corlov/river-gauge/doc/schemas/pinout/pro-micro-pinout.jpg

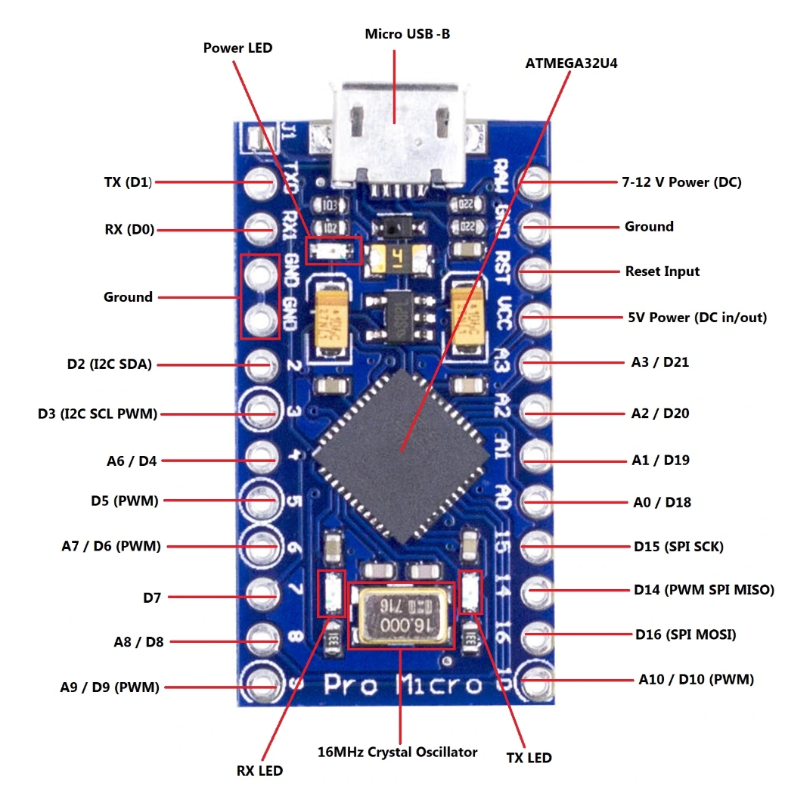
doc/schemas/pinout/pro-micro-pinout.jpg
