corlov/river-gauge/doc/schemas/pinout/sim800L.jpg

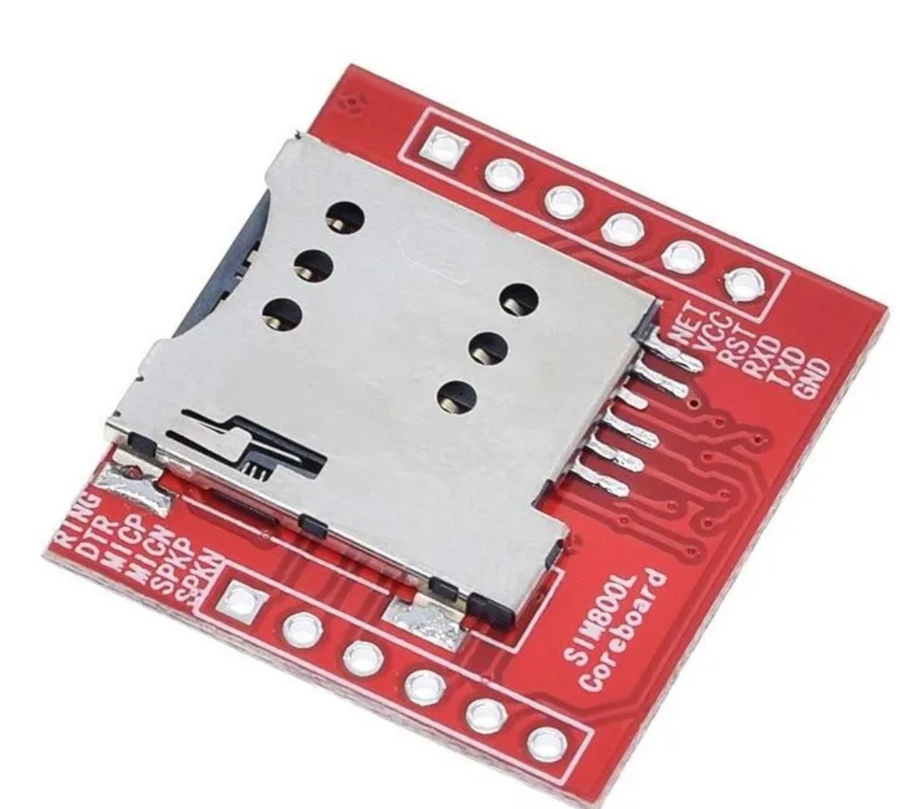
doc/schemas/pinout/sim800L.jpg
