corlov/river-gauge/code/firmware/prod/full_device_esp32_v.08.02.2026/README.md

1) отправлять старые данные
2) резервный сервевер при отправке по MQTT
3) подумать о добавлении признака - это полные данные или только с некоторых сеносров
4) коды ошибок вынести в отдельный модуль как и функцию работы с ними
5) проанализировать какие есть неиспользуемые функции, какие то функци перенести в другие модули

// --- Карта пинов для платы ESP32-S3 ---

// --- Аналоговые пины (ADC1) ---
// A0 = GPIO 1
// A1 = GPIO 2
// A2 = GPIO 3
// A3 = GPIO 4
// A4 = GPIO 5

// --- Встроенные устройства ---
// LED_BUILTIN = 97
//  (Это 'виртуальный' пин для RGB светодиода)

// --- Аппаратный I2C (Wire) ---
// SDA = GPIO 8
// SCL = GPIO 9

// --- Аппаратный SPI ---
// MOSI = GPIO 11
// MISO = GPIO 13
// SCK = GPIO 12
// SS (CS) = GPIO 10

// --- Аппаратный Serial (UART0) ---
// TX = GPIO 43
// RX = GPIO 44
// =============================================================================
