corlov/river-gauge/doc/schemas/pinout/2n2222.jpg

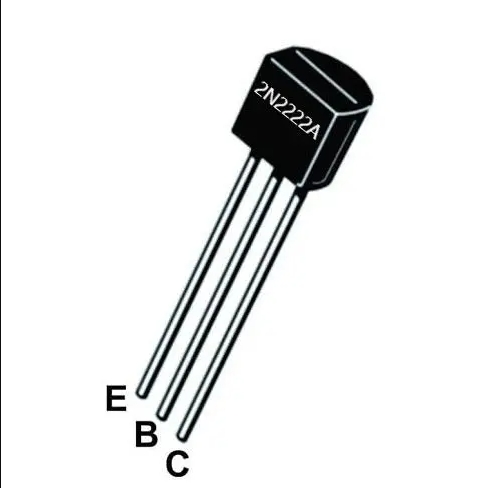
doc/schemas/pinout/2n2222.jpg
