corlov/river-gauge/doc/schemas/pinout/75xx.jpeg

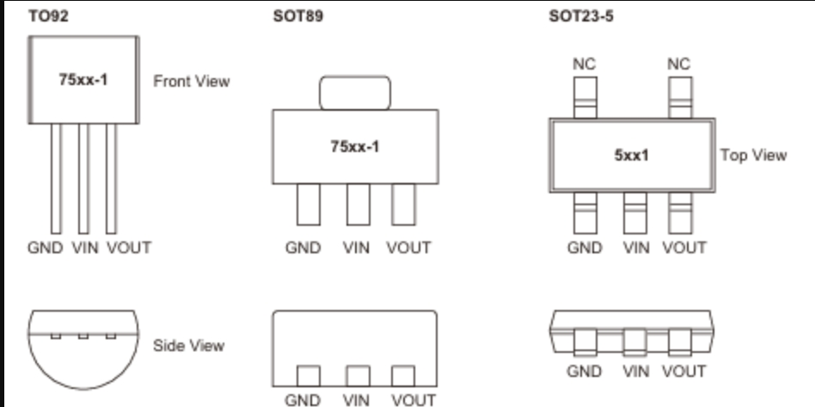
doc/schemas/pinout/75xx.jpeg
