corlov/river-gauge/doc/schemas/pinout/7333A.jpeg

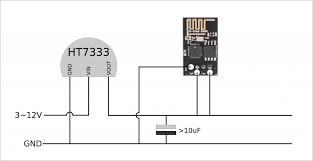
doc/schemas/pinout/7333A.jpeg
