corlov/river-gauge/doc/schemas/pinout/монтаж датчика уровня жидкости.jpg

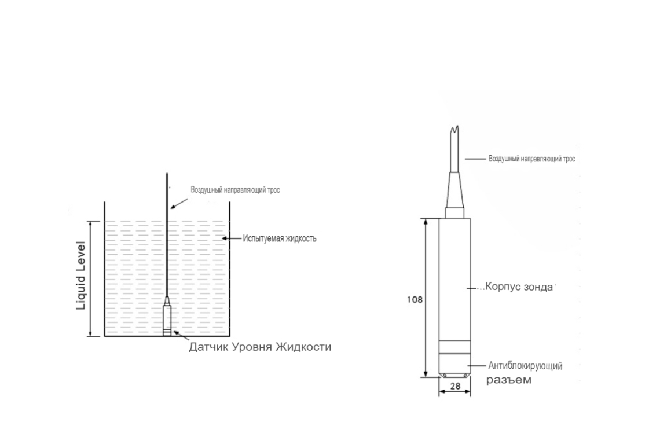
doc/schemas/pinout/монтаж датчика уровня жидкости.jpg
