corlov/river-gauge/doc/schemas/блочная схема/схема.drawio.png

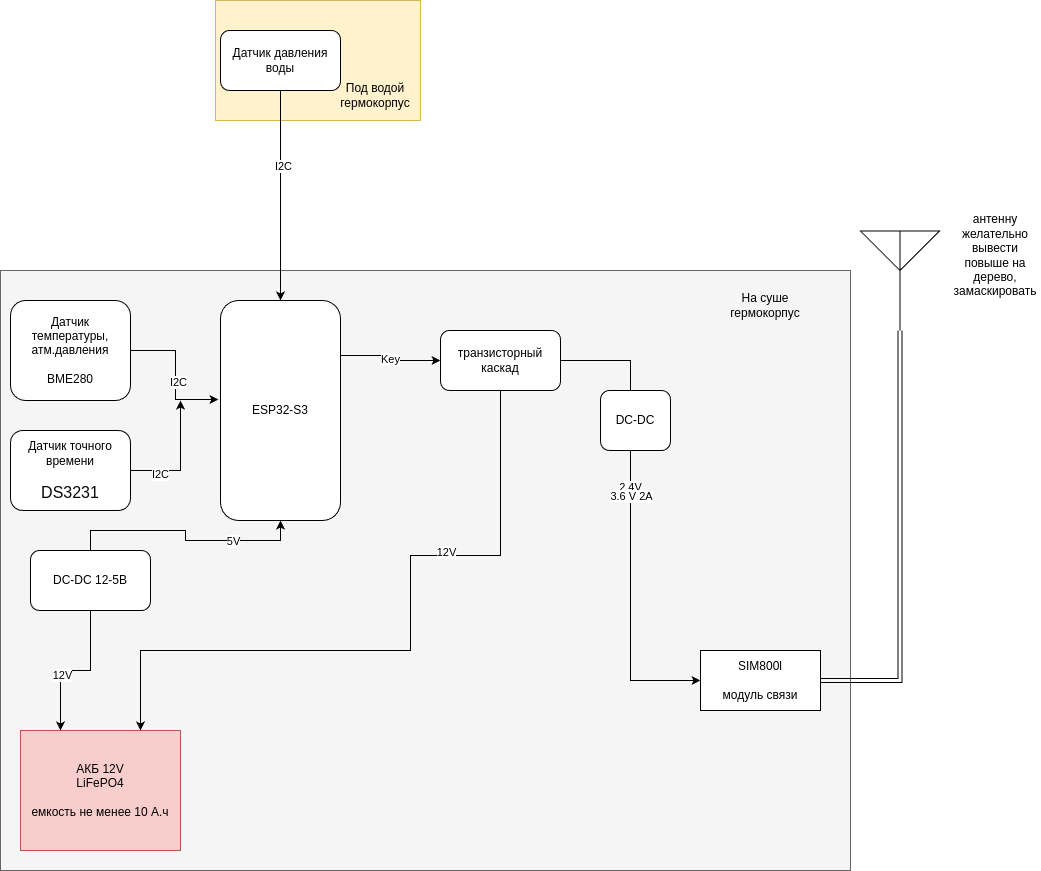
doc/schemas/блочная схема/схема.drawio.png
