corlov/river-gauge/doc/schemas/Общая схема.drawio.png

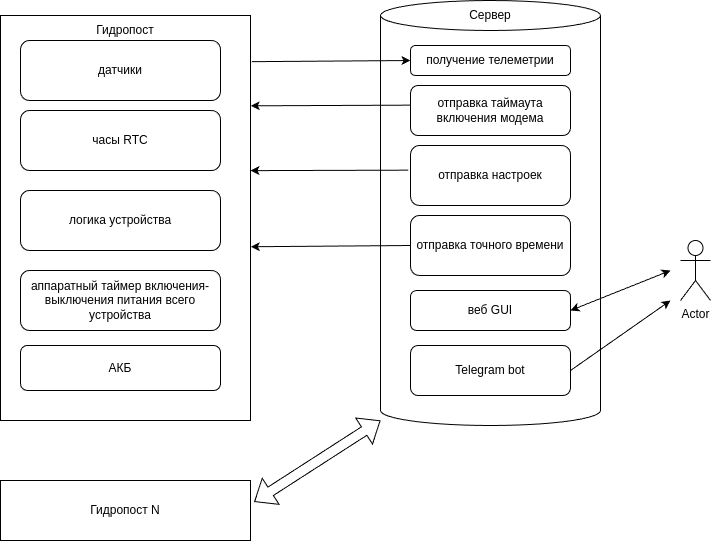
doc/schemas/Общая схема.drawio.png
