corlov/river-gauge/doc/Этапы сборки схемы.jpg

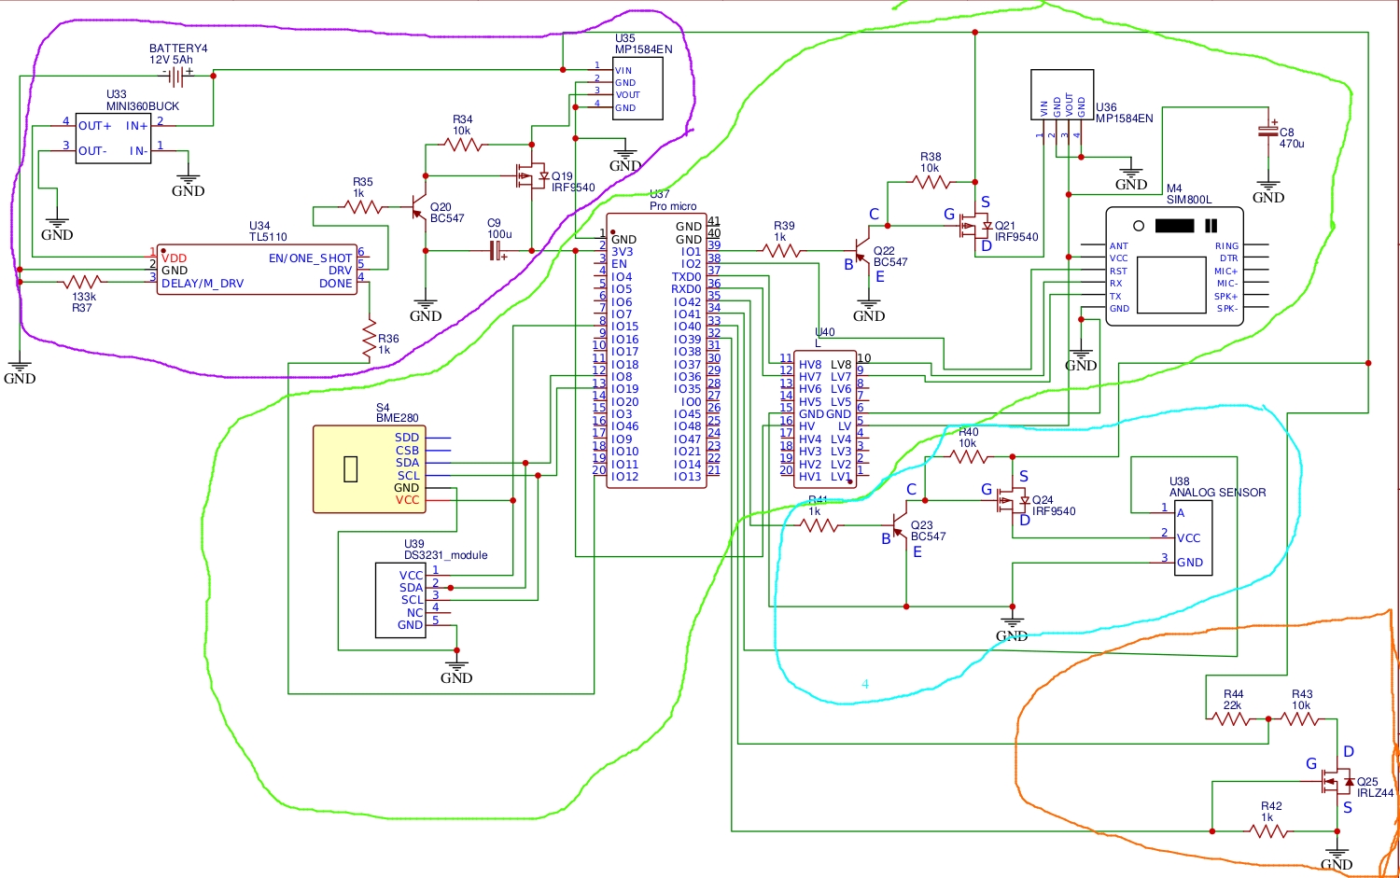
doc/Этапы сборки схемы.jpg
