corlov/river-gauge/pcb_photo_evolution/oct2025/photo_2026-02-10_19-11-00.jpg

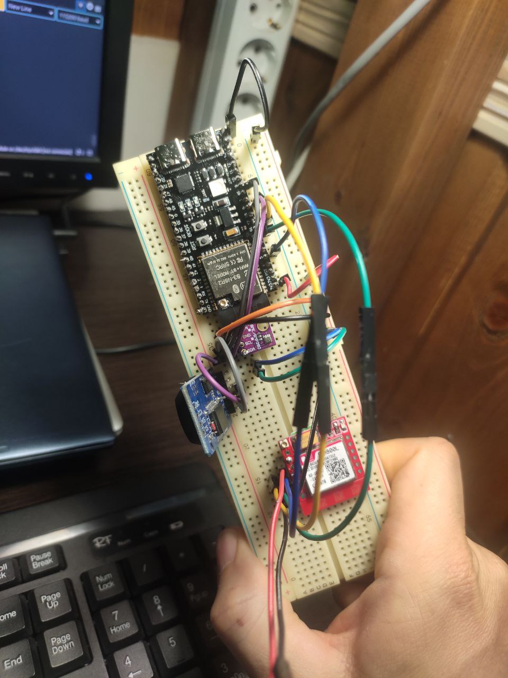
pcb_photo_evolution/oct2025/photo_2026-02-10_19-11-00.jpg
