corlov/river-gauge/pcb_photo_evolution/oct2025/rx-tx.jpg

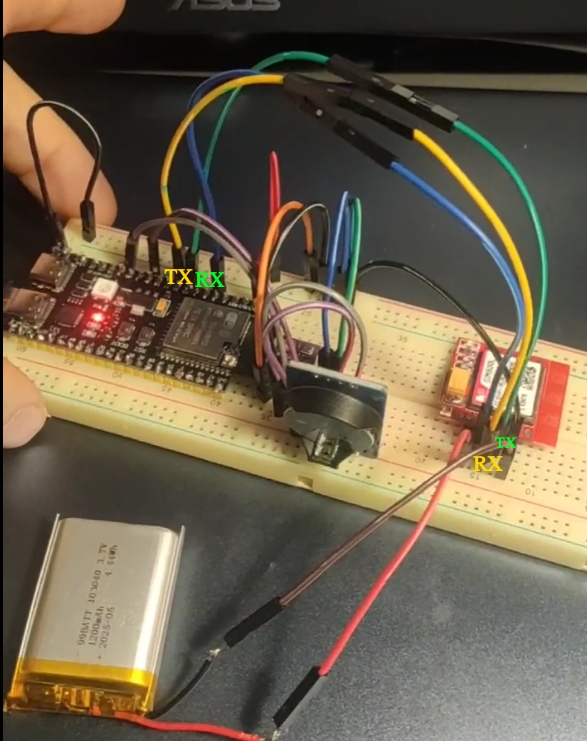
pcb_photo_evolution/oct2025/rx-tx.jpg
