corlov/river-gauge/pcb_photo_evolution/photo_2026-02-08_14-13-37.jpg

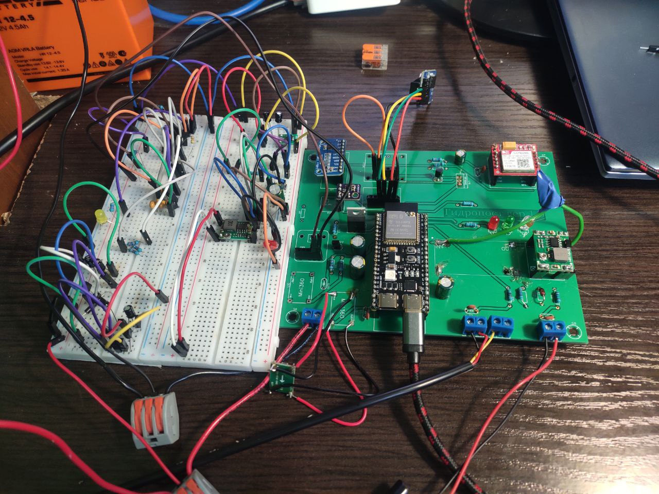
pcb_photo_evolution/photo_2026-02-08_14-13-37.jpg
