corlov/river-gauge/pcb_photo_evolution/photo_2026-02-08_14-15-22.jpg

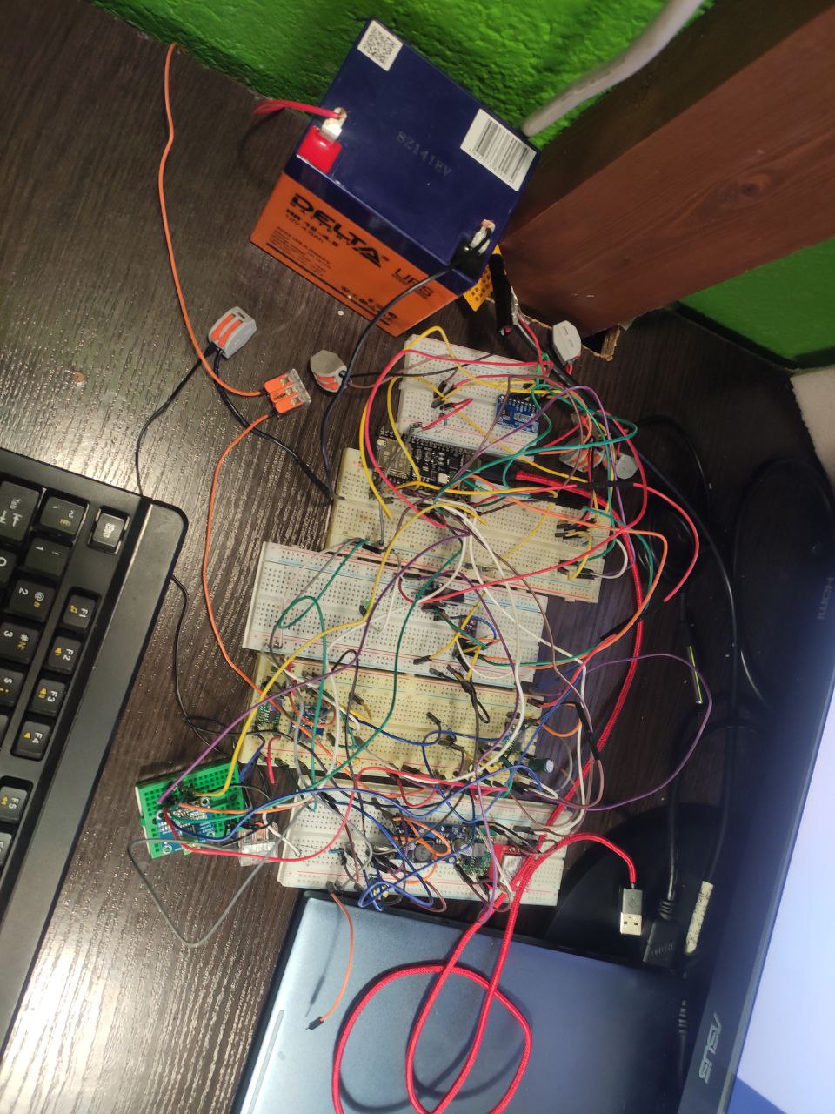
pcb_photo_evolution/photo_2026-02-08_14-15-22.jpg
