corlov/river-gauge/pcb_photo_evolution/photo_2026-02-16_11-09-08.jpg

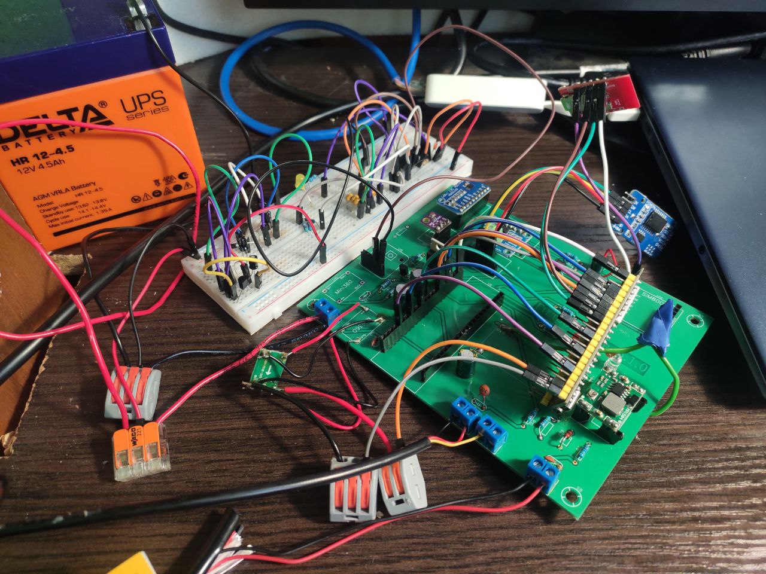
pcb_photo_evolution/photo_2026-02-16_11-09-08.jpg
