corlov/river-gauge/power_timer/1-478-1.jpg

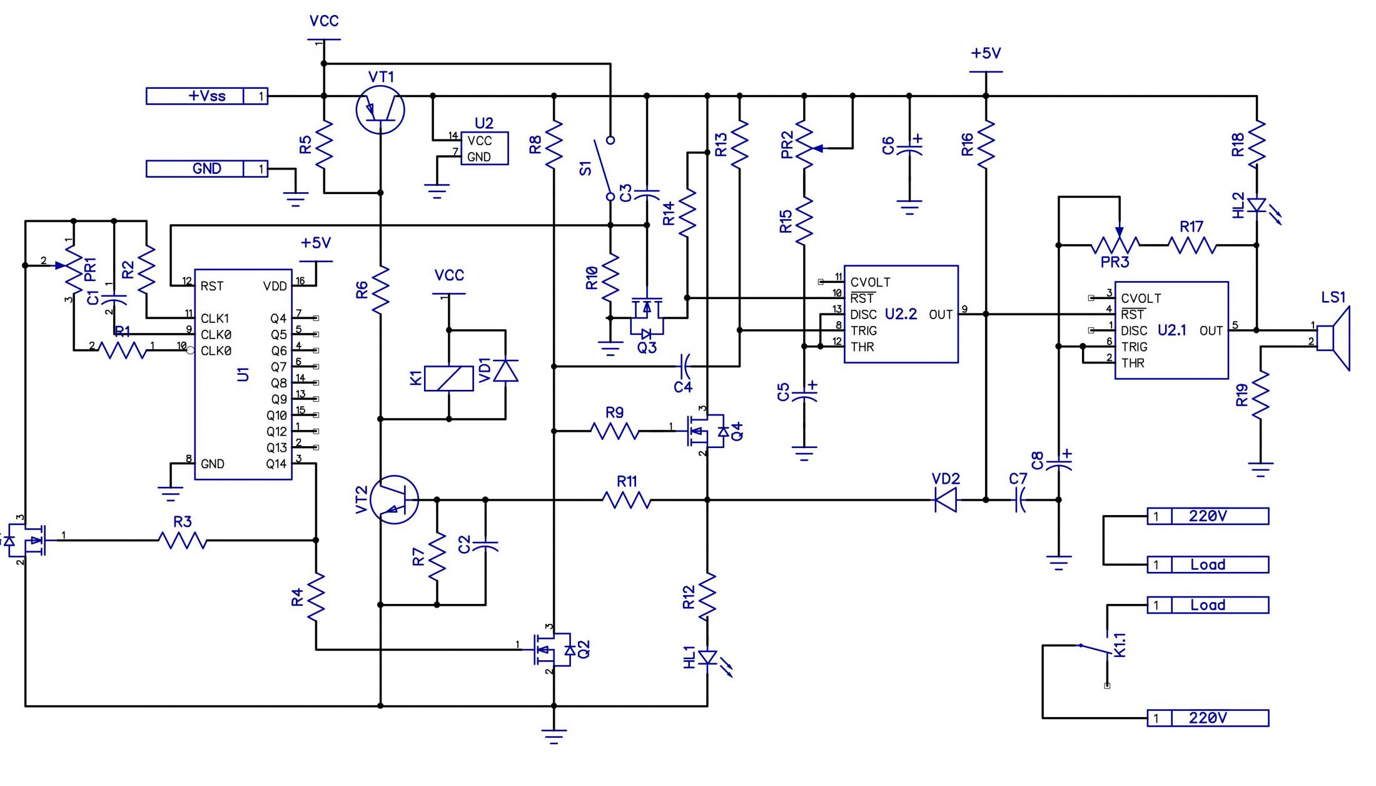
power_timer/1-478-1.jpg
