corlov/river-gauge/power_timer/1n40-1.png

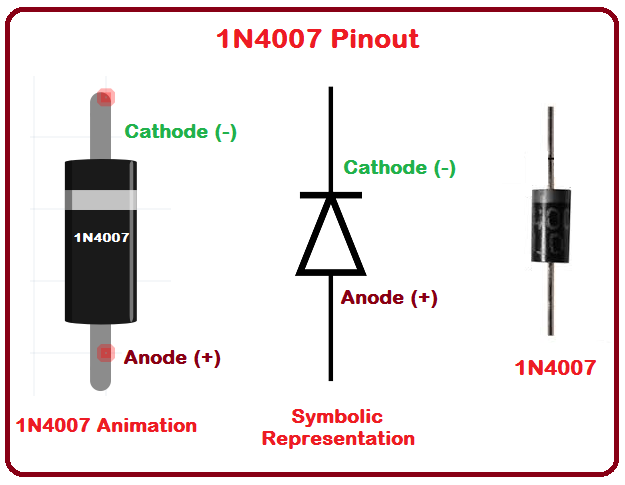
power_timer/1n40-1.png
