corlov/river-gauge/power_timer/559-1.gif

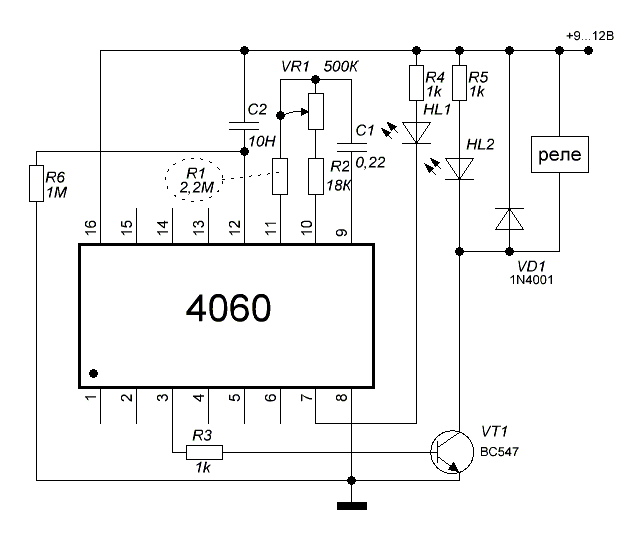
power_timer/559-1.gif
