corlov/river-gauge/power_timer/4060basic.gif

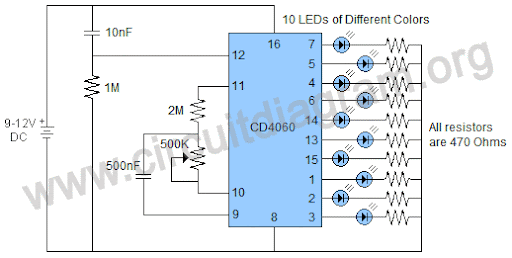
power_timer/4060basic.gif
