corlov/river-gauge/power_timer/7550_power.png

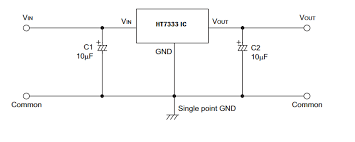
power_timer/7550_power.png
