corlov/river-gauge/power_timer/cd4011.png

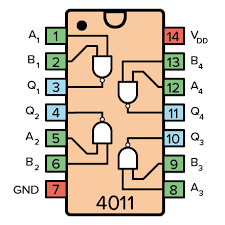
power_timer/cd4011.png
