corlov/river-gauge/power_timer/download.jpeg

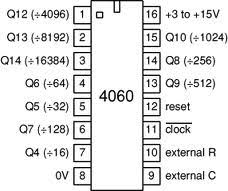
power_timer/download.jpeg
