corlov/river-gauge/doc/Смета.xlsx

позиция | цена | количество | дата | магазин | доставлено | коментарий | критичность для сборки
Модуль плата ESP32-S3-DevKitC-1, Type-C | 645 | 1 | 26.10.25 | озон | да |  | высокая
BME280-5V - модуль датчика атмосферного давления, температуры и влажности | 353 | 1 | 26.10.25 | озон | да |  | высокая
Модуль GSM GPRS SIM800L с антенной | 661 | 1 | 26.10.25 | озон | да |  | высокая
Аккумуляторная батарейка, 3,7 В, 1200 мАч | 247 | 1 | 26.10.25 | озон | да | на время тестов пока не купил настоящий АКБ
Припой для пайки ПОС-61 в катушке с канифолью 0,8 мм, 100 гр | 439 | 1 | 26.10.25 | озон | да | ОБЩЕЕ
Модуль SIM800C - GSM/GPRS + Bluetooth | 893 | 1 | 26.10.25 | озон | да | с антенной чтобы сравнить качество приема с другим модулем связи
DS3231 - Модуль часов реального времени для Arduino (без батарейки) | 150 | 1 | 26.10.25 | озон | да |  | высокая
Паяльник электрический цифровой 80 Вт. Керамический нагреватель. Набор для пайки | 925 | 1 | 26.10.25 | озон | да | ОБЩЕЕ
Беспаечная макетная плата, 830 точек | 163 | 1 | 26.10.25 | озон | да | ОБЩЕЕ
Печатная макетная плата для пайки двухсторонняя 8*12см / зеленая плата под пайку универсальная | 191 | 2 | 26.10.25 | озон | да | ОБЩЕЕ
Медная лента для удаления припоя / Оплетка для выпайки диаметр 1.5 мм длина 1.5 м | 164 | 1 | 26.10.25 | озон | да | ОБЩЕЕ
10 шт., Конденсатор электролитический 10В-470мкФ (470uF-10V, LowESR, -40+105C, 6x7мм) | 174 | 10 | 26.10.25 | озон | да | для сборки ключа отключения модема
Транзистор 2n2222a 10шт. | 123 | 10 | 26.10.25 | озон | да | для сборки ключа отключения модема
Понижающий преобразователь напряжения GSMIN MP1584EN DC-DC (Зеленый | 352 | 2 | 26.10.25 | озон | да | Блок питания для Ардуино и для Модема | высокая
Набор резисторов в футляре 0,25W 600шт 10 Ом - 1 мОм | 480 | 1 | 26.10.25 | озон | да | ОБЩЕЕ
Транзистор IRLZ44N | 144 | 1 | 26.10.25 | озон | да | для сборки ключа общего отключения питания
Модуль MOSFET (силовой ключ) D4184, 5 шт | 411 | 5 | 26.10.25 | озон | нет | взамен схемы ключа отключения модема и др. Ключей | высокая
Понижающий DC-DC преобразователь напряжения Mini360, Модуль-конвертер для Arduino / Ардуино (2 шт.) | 148 | 2 | 26.10.25 | озон | нет | перед таймером
Набор алюминиевых электролитических конденсаторов 0,1 - 220 мкФ, 50 В / Конденсаторы электролитические в боксе | 455 | 1 | 26.10.25 | озон | нет
10шт./лот MCP1700-3302E/TO MCP1700 TO-92 Интегральная схема | 211 | 10 | 26.10.25 | озон | нет
Регулятор напряжения HT7333A | 224 | 1 | 26.10.25 | озон | нет
Низковольтный таймер TPL5110 для энергосберегающих устройств | 699 | 1 | 26.10.25 | озон | нет | таймер отрубания питания | высокая
4шт. Транзистор IRF9540N, 100V, 23A, 150Wt, TO-220, P-канальный | 302 | 4 | 26.10.25 | озон | нет
GY-MS5837 02BA Модуль датчика давления газа и жидкости водонепроницаемый GY-37 | 782 | 1 | 26.10.25 | озон | нет | основной датчик кандидат | высокая
Датчик уровня YB2JF, кабель 5м, 12-32В DC, 420мА (0-10м) | 1771 | 1 | 26.10.25 | озон | нет | основной датчик | высокая
Arduino Pro Micro 3.3V | 621 | 1
макетная плата | 150 | 1
провода папа папа 30 см | 160 | 1
Понижающий DC-DC преобразователь напряжения Mini360, Модуль-конвертер для Arduino / Ардуино (2 шт.) | 138 | 2 | 26.10.25 | озон | нет | перед таймером
4шт. Транзистор IRF9540N, 100V, 23A, 150Wt, TO-220, P-канальный | 280 | 1 | 28.11.2025
10 шт. 1N4744A (1 Вт, 15 В) стабилитрон | 199 | 1 | 28.11.2025
Понижающий DC-DC преобразователь MP1584EN, 2 штуки | 244 | 1 | 28.11.2025
Провода-перемычки DuPont 40шт 10см Папа-Папа Arduino, Raspberry Pi, STM32, NodeMCU | 332 | 2 | 28.11.2025
Беспаечная макетная плата (breadboard) MB-102, 830 точек, для Arduino и прочих устройст | 265 | 1 | 28.11.2025
Arduino NANO V3.0 Atmega328 CH340 Type-C (пины не припаяны | 291 |  | 28.11.2025
модуль АЦП ads1115 | 288 |  | 28.11.2025
Модуль плата ESP32-S3-DevKitC-1, Type-C | 857 |  | 28.11.2025
INA219 Модуль MCU-219 датчика тока и напряжения с i2C интерфейсом для Arduino | 454 |  | 28.11.2025
Адаптер подключения датчика температуры DS18B20 | 235 |  | 28.11.2025
20шт Керамический конденсатор 104 жёлтый 5 | 234 |  | 28.11.2025
Распределительная коробка ABS | 912 |  | 28.11.2025
Регулятор напряжения и тока понижающий DC-DC XL4015E1 5А для заряда литий ионного АКБ | 219 |  | 28.11.2025
Повышающий регулируемый DC-DC преобразователь XL6009E1 Uвх.5 - 32, Uвых.5 - 35 В 4А | 164 |  | 28.11.2025
10 шт., Конденсатор электролитический 25В-470мкФ (470uF-25V, LowESR, -40+105C, 8x12мм) | 208 |  | 28.11.2025
Понижающий DC-DC преобразователь напряжения Mini360, Модуль-конвертер для Arduino / Ардуино (2 шт.) | 138 |  | 28.11.2025
производство на заводе | 3306 |  | 07.12.2025
 | 20802
