corlov/river-gauge/TODO.md

Global

1) Энергоэффективность.
    
    сейчас энергопотребление стало лучше, но все равно недостаточно оптимально
    файл с испытаниями и статистикой прикладываю в каталоге power_efficency (stata2.csv)

    Например возьмем замеры:
        21.02.2026 02:00-  11.95 В
        23.02.2026 21:00 - 11.90 В

    АКБ - бу свинцовый 12В 4.5Ач

    т.е. за 3 суток упало на 0.05В получается, что если считать полным заряд 12.5В, а полный разряд 10.0В, то 
    хватит на 50 дней данного АКБ.

    Вопросы:
        1) Что будет если это будет новый Li/LiFePo4/LiPo АКБ? Увеличиться ли время работы?
        2) Увеличить емкость АКБ в 6 раз (что даст 300 дней приемлемые)?
        3) Почему отдельно устройство на мекетке состоящее из таймера (который работает постоянно) и ЕСП32 питаемой через мосфет потребляет менее 0.01В за сутки?
        А устройство состоящее из такого же таймера + ЕСП32 + датчики и ДЦДЦ преобразователи и модуль связи (которое тоже таким же мосфетом отключается от питания)
        потребляет 0.05В за сутки?
        Получается что я не обеспечиваю полное отключение схемы и она что то жрет?

    Что делать:
        1) ты уверен что делаешь измерения правильно - ты же делал мультиметром обычным а сейчас через цифровую микросхему причем на включенном устройстве.
        Предлагаю сделать замер мультиметром как ты делал раньше и посомтреть-сравнить

        2) собрать устройство на макетке и также сделать замеры мультиметром и через схему. написав прошиву чтобы печатало через сериал порт содержимое журнала
        Устройство состоит из:  таймера, есп32, мосфет схемы включения и выключения, вольтметра, модуля связи.

+ 2) тестировать как работает или нет устройство при различных входных напряжениях
        работает в диапазоне от 8.8 до 13.0

Для начала подавать разное напряжение на DC DC настроеный преобразователь попробуй и посомтри что будет на выходе. М.б. уже не так будет?

При этом обязательно припаять DC-DC преобразователь иначе на датчики и прочие модули пойдет неправильное напряжение

+ 3) собрать независимо еще одну схему с таймером - цель убедиться что работает

+ 4) предусмотреть программный ватчдог чтобы вырубать устройство если оно "подвиснет"

+ 5) проверить tx-rx еще раз и попробовать перепрограммировать утсройство, чтобы по другому тоже заработало (накрест)
    Старая сборка на макетке:
        на 15 пин Rx (физически 8ой сверху) ESP приходит провод от Tx моудля SIM800L (ближе к GND)
        на 16 пин Tx (физически 9ый сверху) ESP приходит провод от Rx моудля SIM800L

6) по плате:
    предусмотреть вариант с 7533 - м.б. будет работать на нем - тогда сильно меньше элементов будет
    попробовать размер платы в меньшую сторону отыграть

================================================================================
Local

2) Прошивка что доработать:
    1) 
    Сейчас логируются в основном только данные.
    Идея: хранить в файле не только CSV измерений, но и события: ERR_CODE;timestamp;bootCount;описание. Тогда на отладке по флеш‑логу можно понять, почему устройство часто перезагружается или не шлёт данные.

    2) Настройки приходят по HTTP/MQTT и сразу пишутся в NVS.
    Идея: перед записью в Preferences проверять диапазоны (например, CURRENT_MIN_MA, RESISTOR_OHMS), чтобы «битые» настройки с сервера не ломали измерения.

    3) Сейчас индексы полей захардкожены (0,1,2,3…) в разных местах.
    Идея: ввести перечисление enum CsvFieldIndex { CSV_BOOT=0, CSV_TIME=1, ... }, чтобы не было «магических чисел» и легче сопровождать при добавлении полей.

    4) добавить диагностический лед - т.е. он загорается если все датчики ОК

    5) Сейчас чтение любого из I2C‑датчиков может привести к миганию кодом ошибки.
    Идея: пометить, какие сенсоры критичны (например, уровень воды) и при их отказе явно менять статус пакета/логики тревог, а не просто писать -1024.

    6) Режимы работы по сезону/сценарию:
    Идея: несколько профилей: «межень» (редкие измерения, маленький объём передачи) и «паводок» (частые измерения, больше телеметрии, возможно, локальное кэширование).

    7) Серверные алгоритмы:
    Построение графиков уровней, прогноз по простым моделям (скользящее среднее, детекция тренда подъёма),
    автоматическая генерация оповещений (почта/бот) при резком росте уровня.

    8) настройками управлять опросом включение/отключение отдельных сенсоров

================================================================================

================================================================================================================

/home/kostya/SillyTavern/data/default-user/chats/default_Assistant/Assistant - 2025-10-18@11h02m10s.jsonl

1) заменить ESP32 на ардуино нано или еще что то с низким энергопотреблением
    режим сна теперь не нужен
    интерфейсы:
        i2c
        tx, rx - модем
        цифровые выходы - минимум 8 штук, лучше 12

------------------------------------------------------------------------------------------------
1) Реализовать схему с отключением общего питания по таймеру
При этом раз в полчаса питание должно подаваться
Ардуина быстропроеверяет была ли успешной отправка данных в центр предыдущая, если была, то отключаемся
Либо что с момента последнего отправления прошло более 8 часов, т.е. это 16 запуск.
Если запусков было более 16 и отправка не удалась то каждый раз пытаемся отправить.

2) Реализовать схему с подключением питания модуля связи и датчика уровня

3) как определять уровень заряда АКБ?
    "Уровень заряда АКБ через Делитель логически отключаемый.jsonl"
    Уровень заряда напрямую связан с напряжением.
    Через делитель нарпяжения получать на аналоговый вход арудины значения с + клеммы
    Делитель подключать только через Мофсет иначе будет утекать постоянно ток с делителя

Шаги:
    1) аппаратная схема общего откл. питания
    2) датчик давления
    3) усоверш. схема питания (отключение модуля связи и датчика)
    4) схема делителя напряжения
    5) сбор в корпусе

------------------------------------------------------------------------------------------------

Открытые вопросы:
    1) поскольку устройство в основном будет спать и включаться заведется ли оно на морозе? Не все компоненты точно климатические
        Возможно его придется ставить непосредственно весной перед паводками
    2) будет ли вытягивать 2Ж связь, по зоне покрытия - да, хотя якобы 3ж и 4ж вытесняют 2ж но пок атре покрытия это не  так - делаем ставку на 2ж
    4) адекватность работы датчика глубины

# Советы от ИИ

## Подключить SIM800L

Питание: ВАЖНО! Не питай SIM800L от пина 3.3V или 5V на ESP32. Ему нужен ток до 2А в пике. Используй отдельный Li-Po аккумулятор или понижающий DC-DC преобразователь, подключенный к источнику питания.
Управление питанием: Пин, который ты выбрал для управления транзистором (например, GPIO4), подключай к базе транзистора.
Serial (UART):
ESP32 TX (например, GPIO17) -> SIM800L RX
ESP32 RX (например, GPIO16) -> SIM800L TX
Не забудь соединить земли (GND) ESP32 и источника питания SIM800L.

https://microkontroller.ru/esp32-projects/podklyuchenie-gsm-modulya-sim800l-k-esp32/

## Связь

Используйте 4G/LTE модуль, например, SIM7600 или A7670.
Почему это лучше:
Покрытие: Сети 4G (LTE) имеют гораздо лучшее покрытие и проникновение сигнала, особенно в сельской местности.
Надежность: Модуль сможет работать в сетях 4G, а если их нет — переключится на 3G или 2G. Это дает максимальный шанс оставаться на связи.
Будущее: Сети 4G будут работать еще очень долго.
Да, эти модули дороже, но для ответственной задачи, где важна надежность связи, экономить на модуле не стоит. К ним так же нужно будет подключать хорошую внешнюю LTE-антенну.

## Герметизация датчика и передача сигнала от датчика на микроконтроллер

Способ: Профессиональный (с герметизацией датчика)
Этот способ предполагает погружение самого датчика в воду, но в специальной защите.

Берем герметичный корпус (опять же, коробка IP67/IP68 или отрезок сантехнической трубы с заглушками).
В стенке корпуса сверлим отверстие чуть больше диаметра металлической части датчика MS5837.
Монтируем плату внутри корпуса так, чтобы металлическая часть датчика "смотрела" наружу через это отверстие.
Тщательно герметизируем зазор между корпусом и металлической частью датчика. Для этого идеально подходит двухкомпонентный эпоксидный клей или хороший морской герметик. Это самый ответственный этап! Нужно убедиться, что вода никак не сможет попасть внутрь.
Выводим провода из корпуса. Для этого используем специальный гермоввод (кабельный сальник). Он зажимает кабель резиновым уплотнителем и не дает воде попасть внутрь.
Всю конструкцию погружаем на дно.
Плюсы:
Максимальная точность измерений, так как датчик находится непосредственно в измеряемой среде.
Более компактное решение.
Минусы:
Сложнее в изготовлении.
Есть риск протечки, если герметизация выполнена некачественно.
Что еще нужно учесть:
Длина кабеля: Интерфейс I2C, по которому работает датчик, не любит длинные провода. Если расстояние от датчика до вашего микроконтроллера больше 1-2 метров, могут начаться проблемы со связью. Решения: использовать специальные расширители I2C (например, на P82B715) или разместить микроконтроллер (например, маленький Arduino Pro Mini или ESP8266) прямо в герметичном корпусе рядом с датчиком, а от него уже передавать данные на "базу" по более дальнобойному интерфейсу (RS-485, LoRa, Wi-Fi).
Калибровка: Перед погружением обязательно измерьте давление на воздухе. Это будет ваше "нулевое" значение (атмосферное давление). Глубина будет рассчитываться из разницы между давлением на дне и этим атмосферным давлением.
