corlov/river-gauge/doc/schemas/easyeda/03-12-2025/Schematic_ESP32-v3_01-12-2025_2025-12-03.pdf

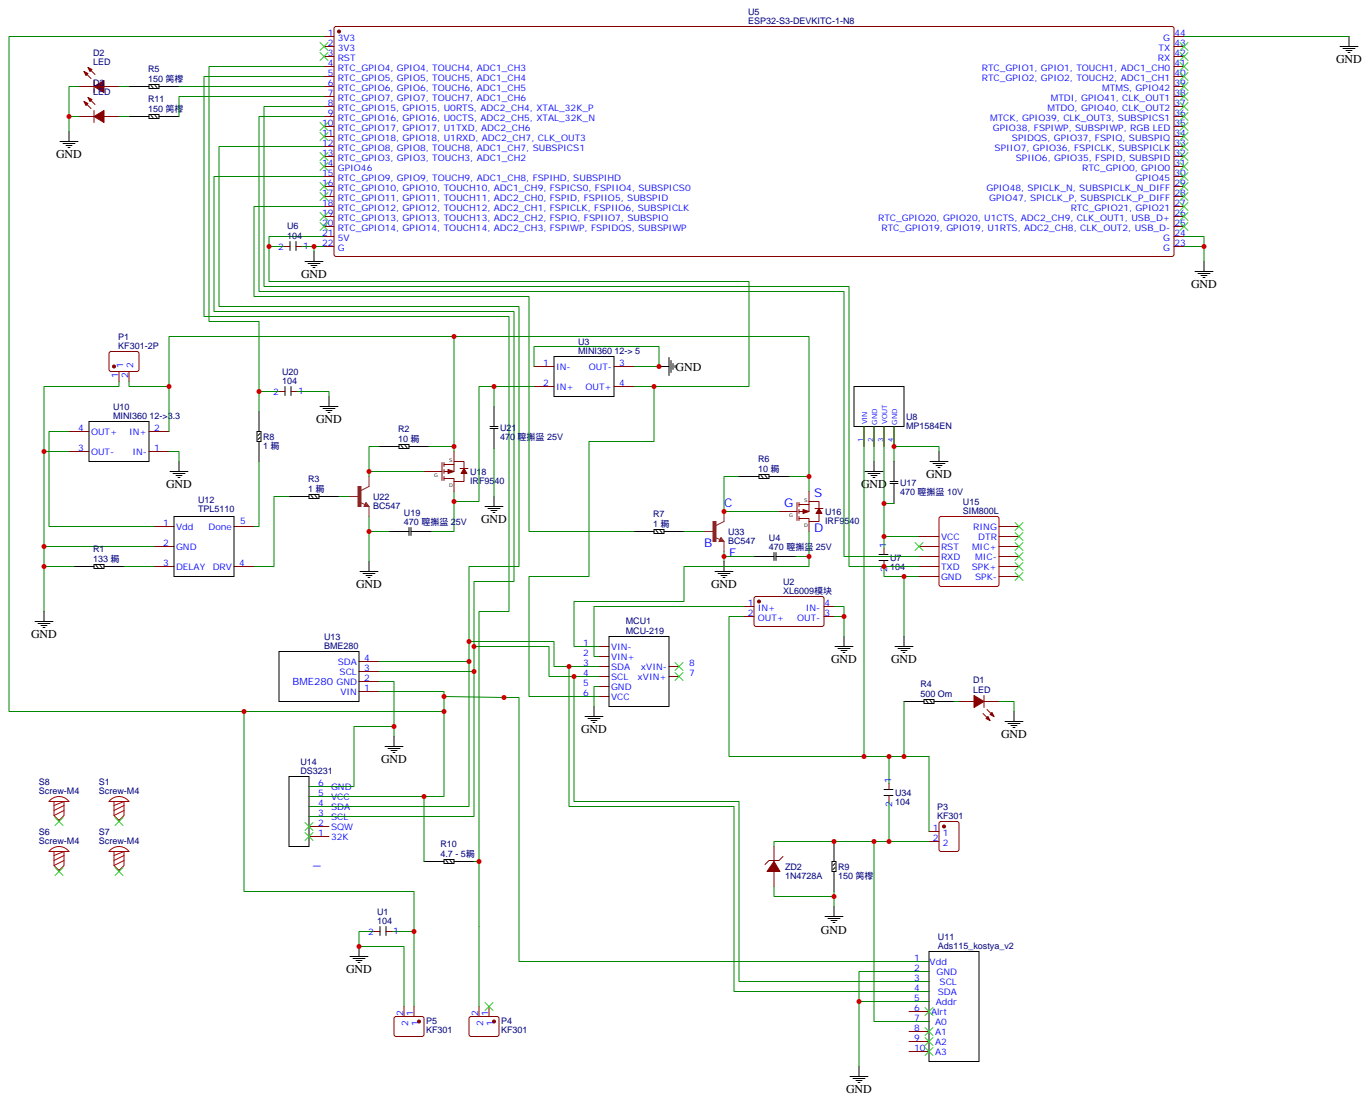
[picture p26: page 1]

35 MTCK, GPIO39, CLK_OUT3, SUBSPICS1
34 GPIO38, FSPIWP, SUBSPIWP, RGB LED
SPIDQS, GPIO37, FSPIQ, SUBSPIQ
32 SPIIO7, GPIO36, FSPICLK, SUBSPICLK
SPIIO6, GPIO35, FSPID, SUBSPID
