corlov/river-gauge/doc/schemas/easyeda/19-11-2025/Schematic_ESP32-v1_2025-11-18.pdf

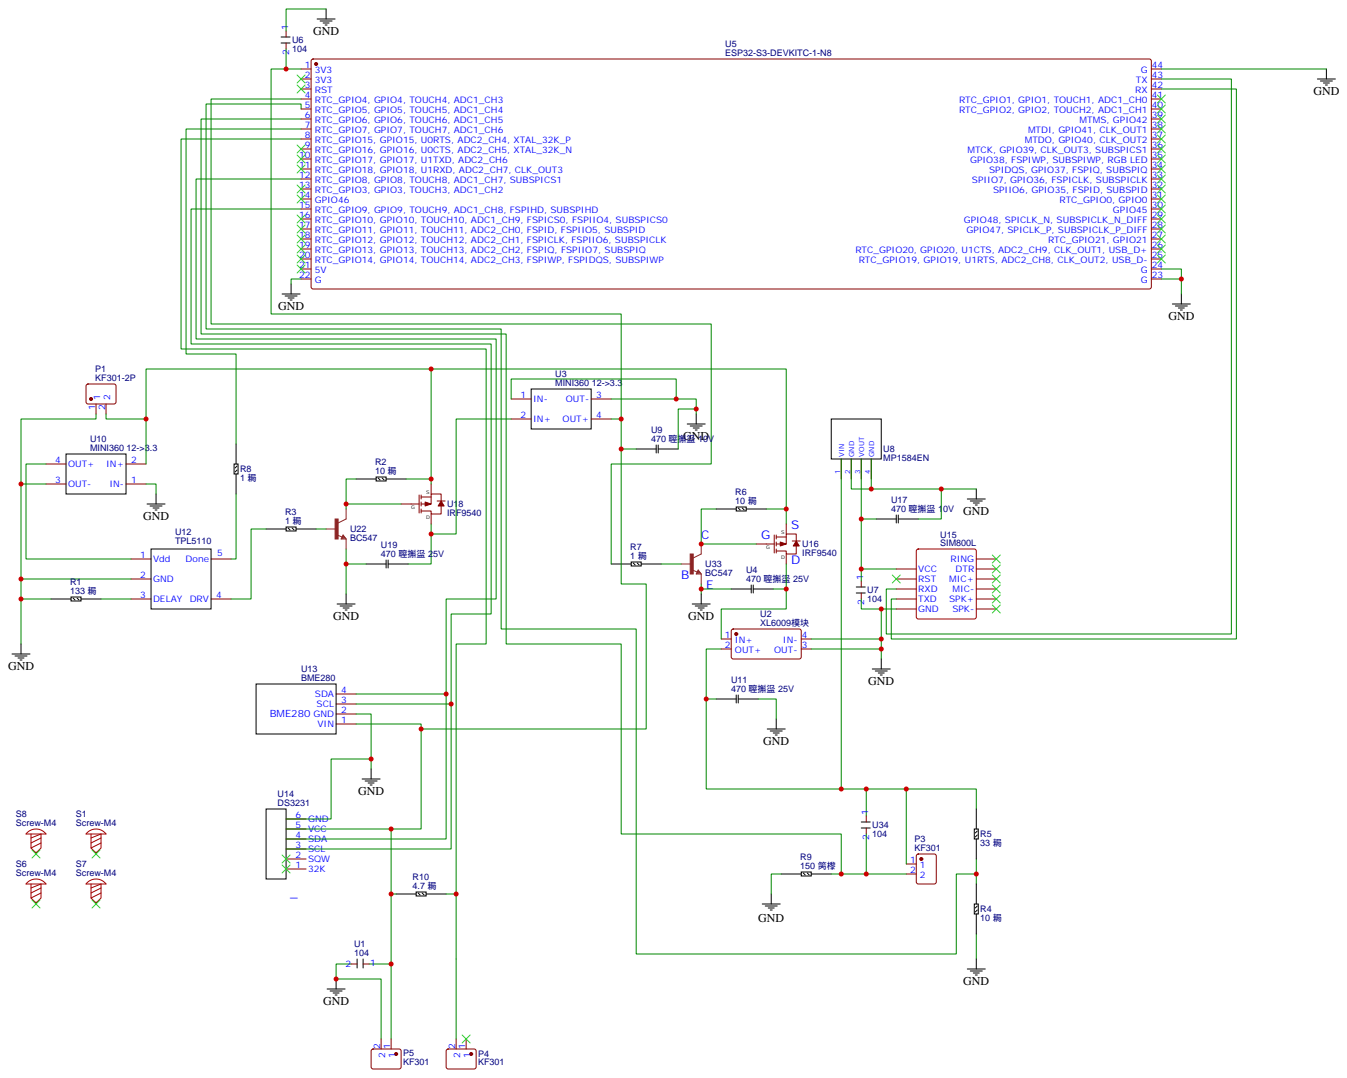
[picture p27: page 1]

35 MTCK, GPIO39, CLK_OUT3, SUBSPICS1
34 GPIO38, FSPIWP, SUBSPIWP, RGB LED
33 SPIDQS, GPIO37, FSPIQ, SUBSPIQ
32 SPIIO7, GPIO36, FSPICLK, SUBSPICLK
31 SPIIO6, GPIO35, FSPID, SUBSPID
