corlov/river-gauge/doc/schemas/easyeda/18-11-2025/Schematic_New-Project_2025-11-12.pdf

## Battery 12v

5 Ah

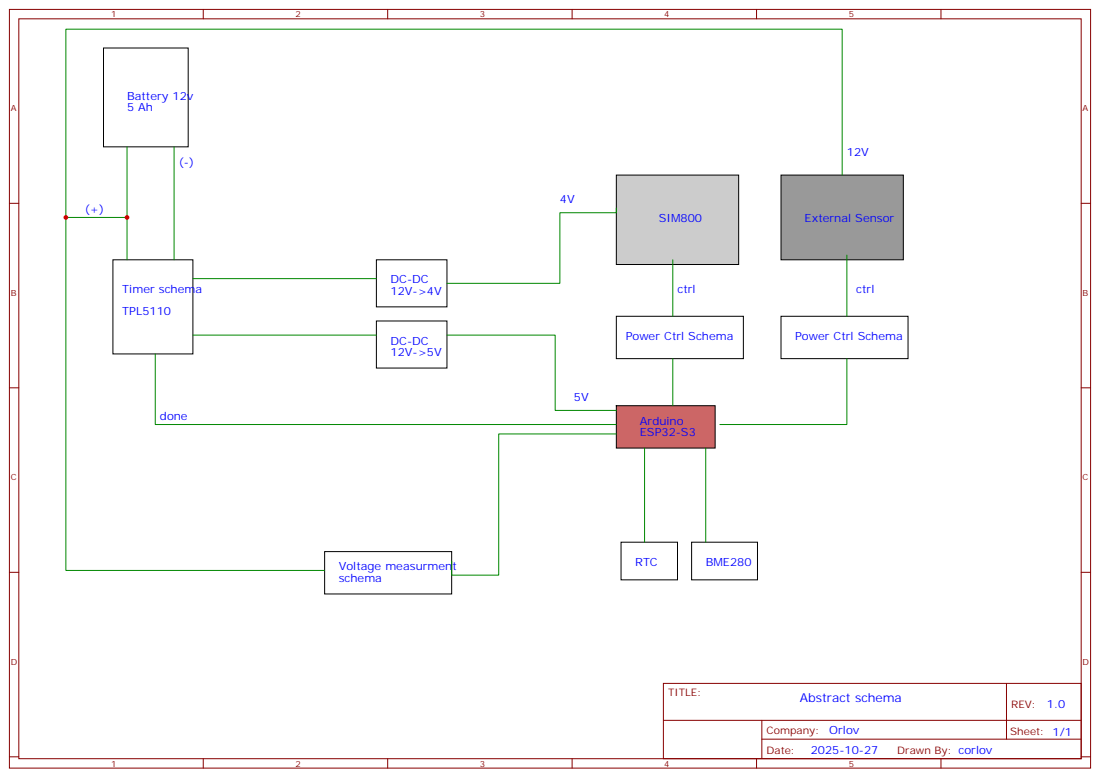
[picture p28: page 1]

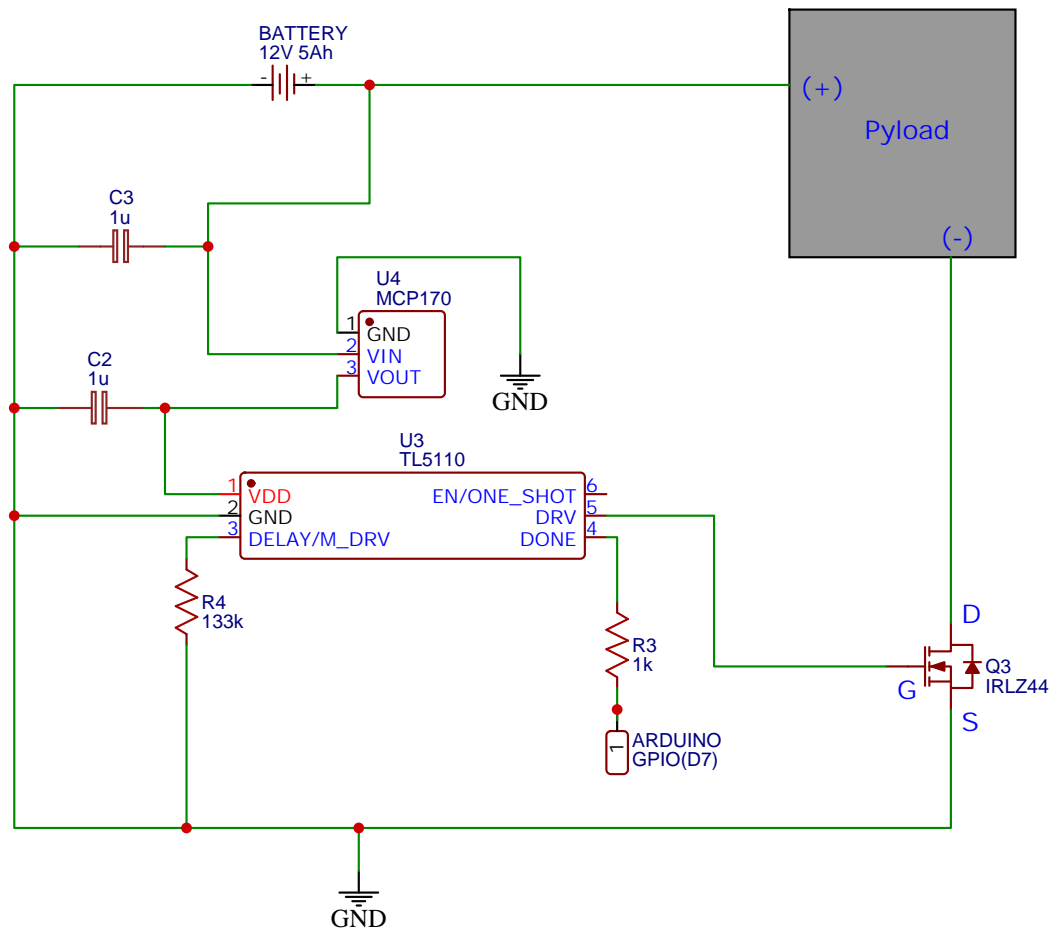
[picture p29: page 2]

S
G

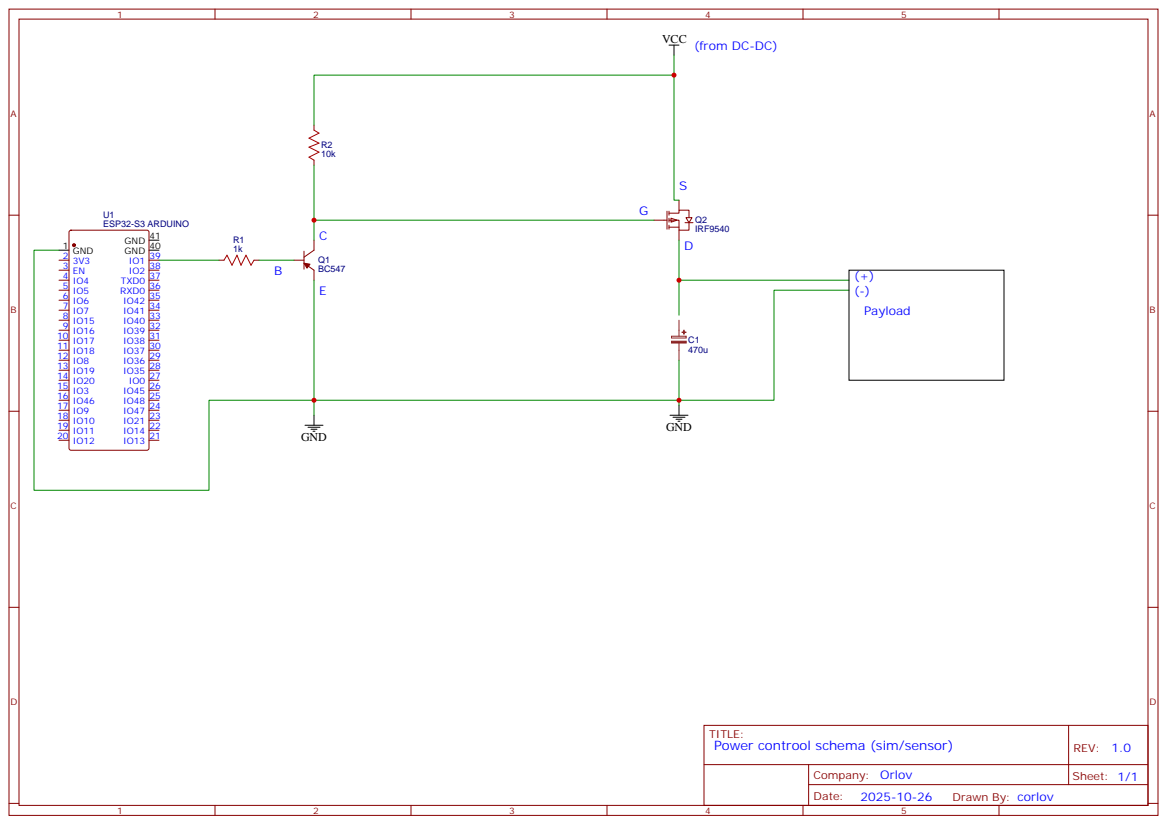
[picture p30: page 3]

## Battery (+12V)

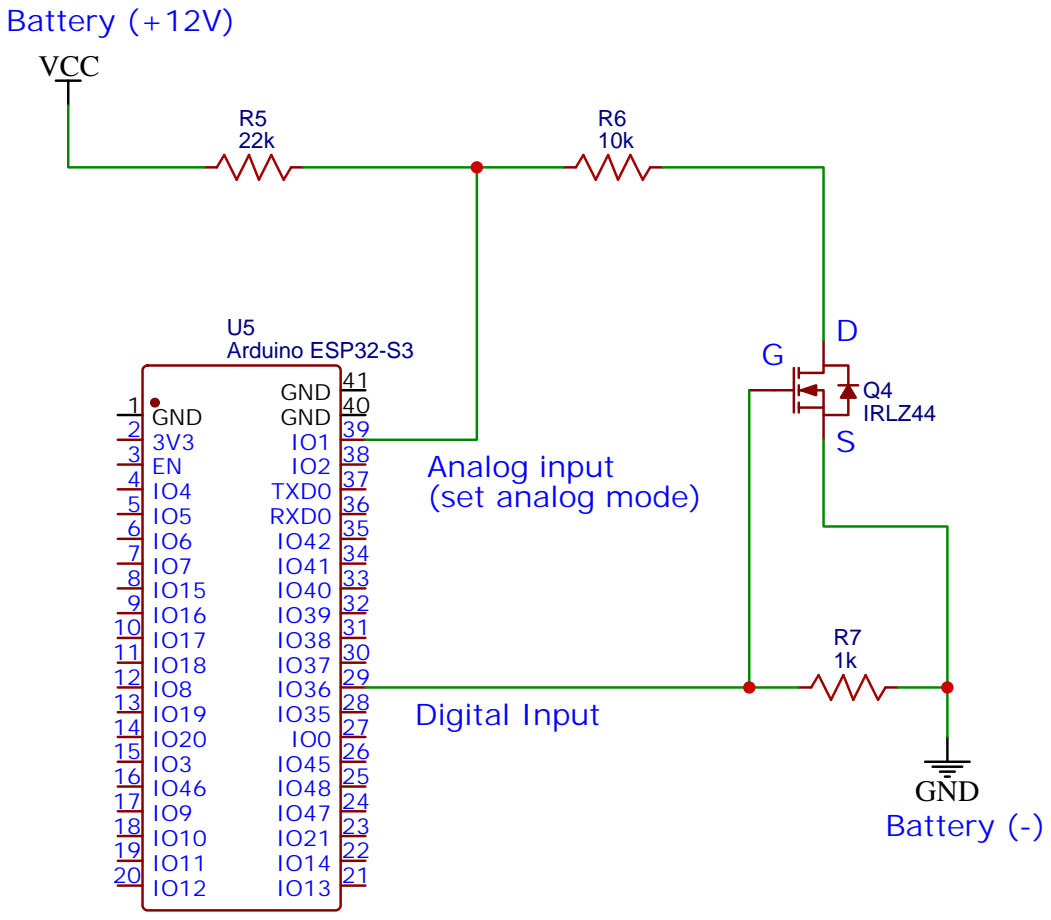
[picture p31: page 4]

(+)

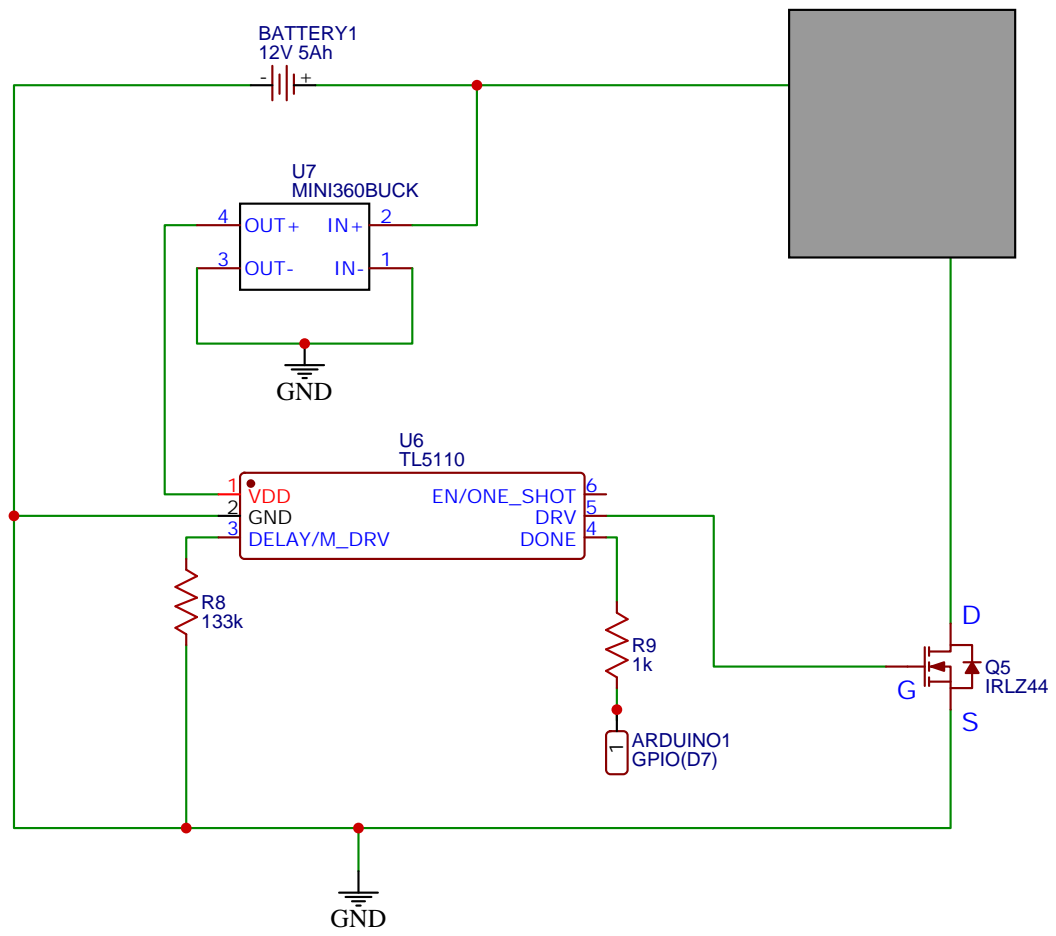
[picture p32: page 5]

D

C | G

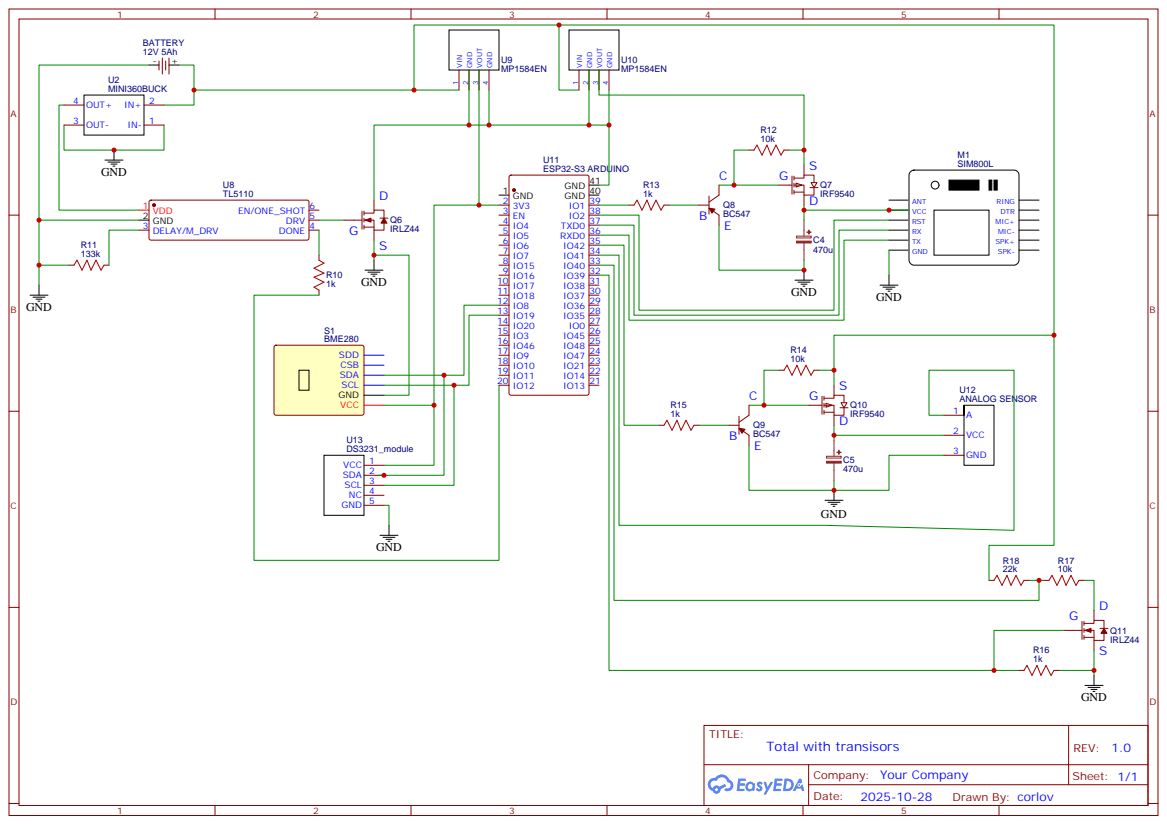
[picture p33: page 6]

# GND 5 gnd

D4184

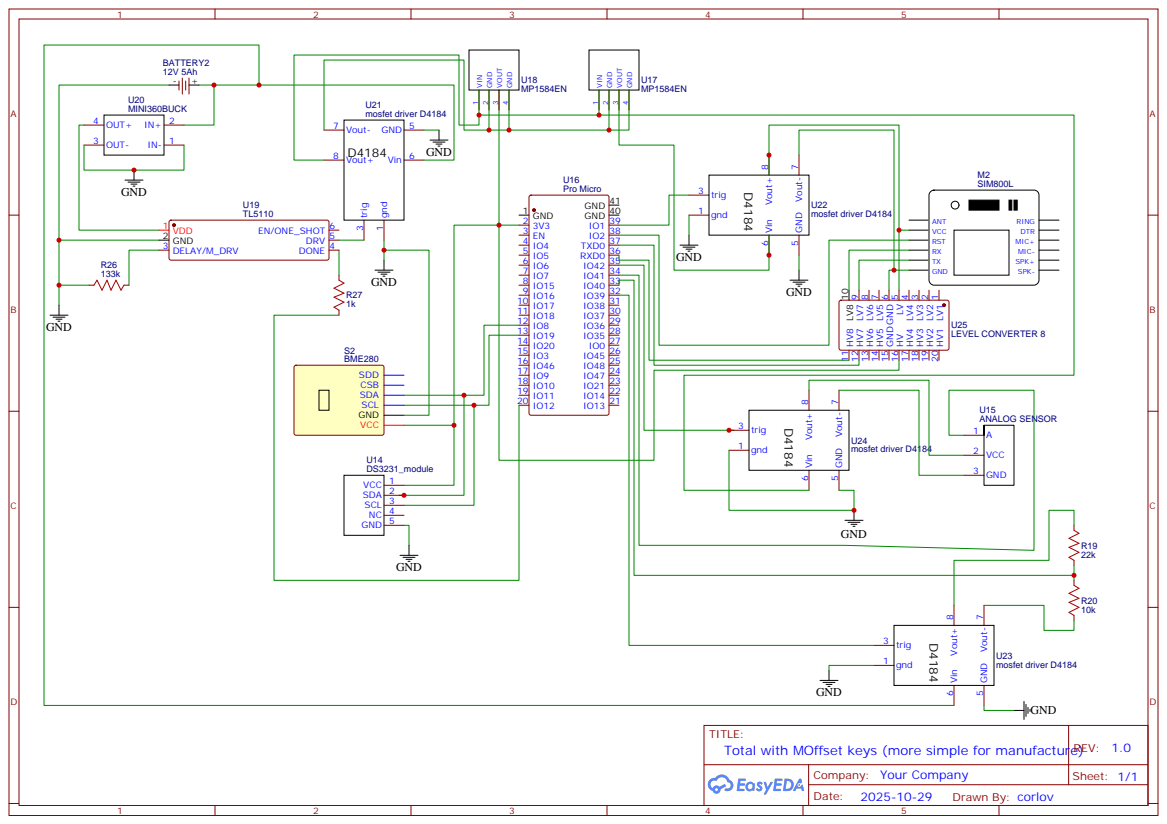
[picture p34: page 7]

TITLE:
Total with MOffset keys (more simple for manufacture)REV: 1.0

S
C | G

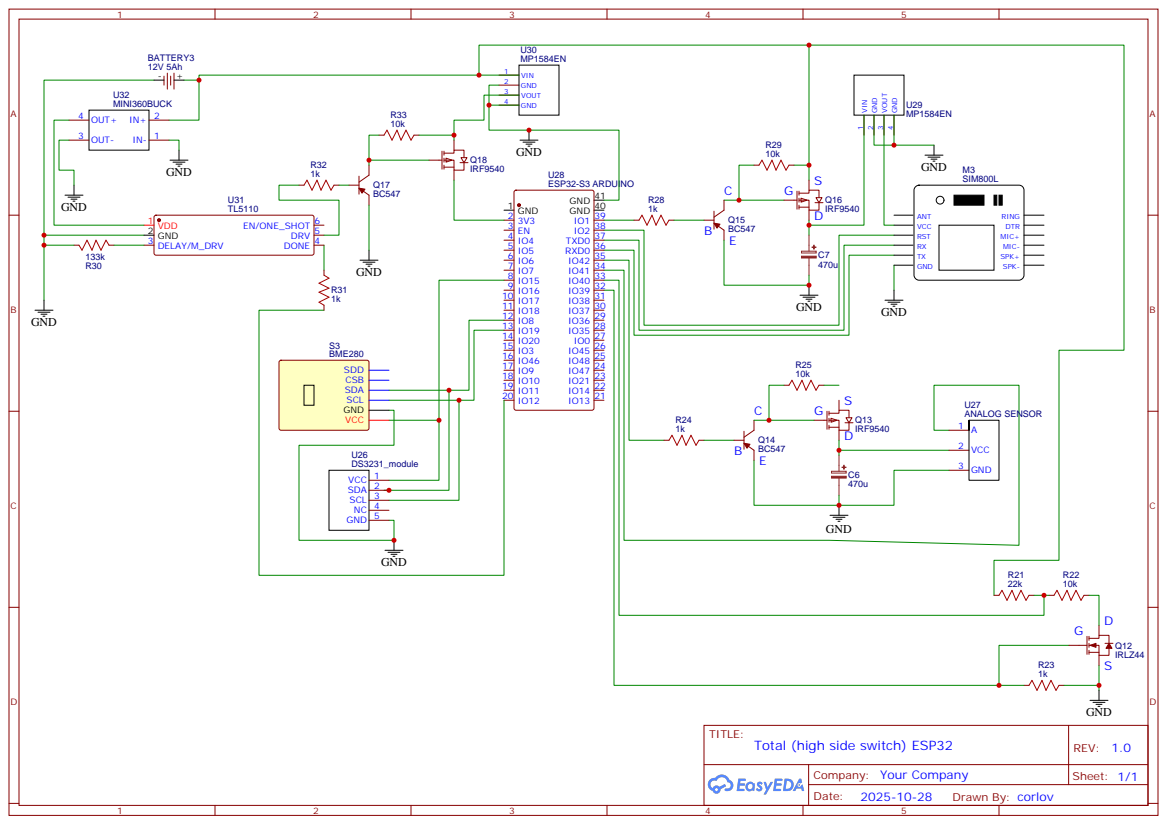
[picture p35: page 8]

C | G

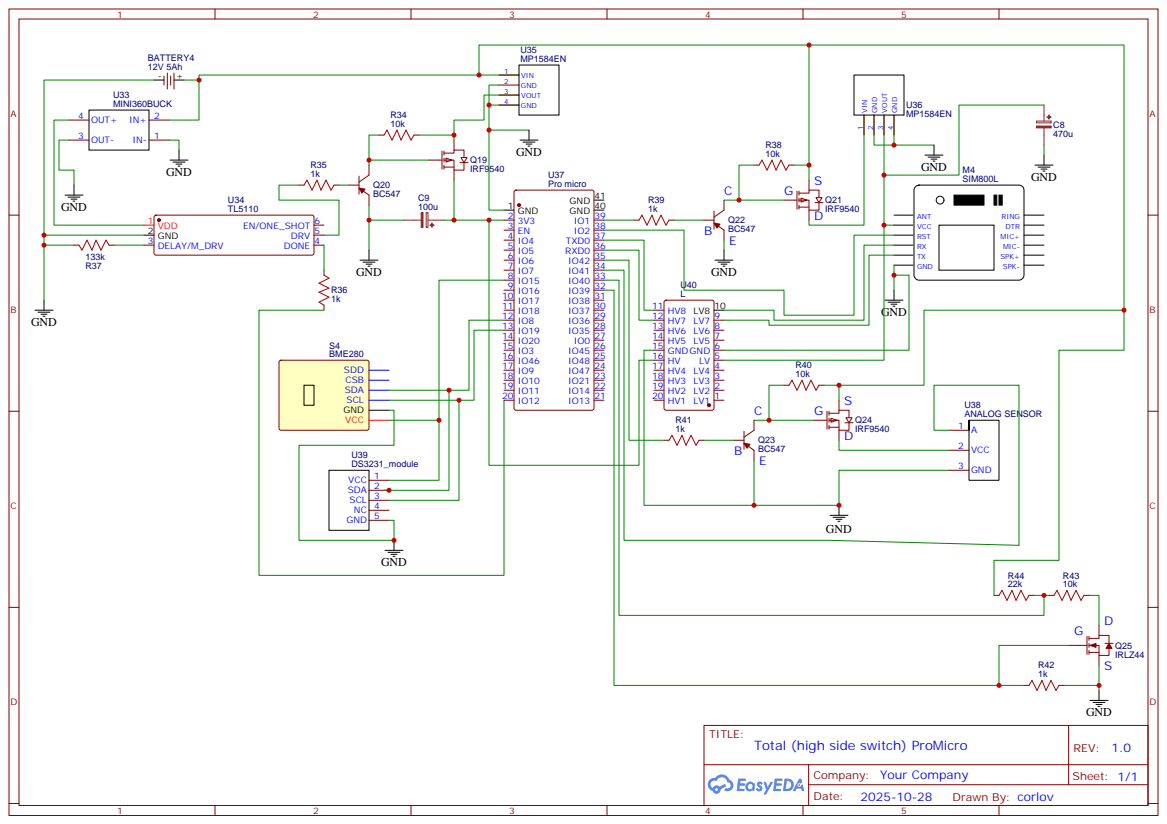
[picture p36: page 9]

C | G

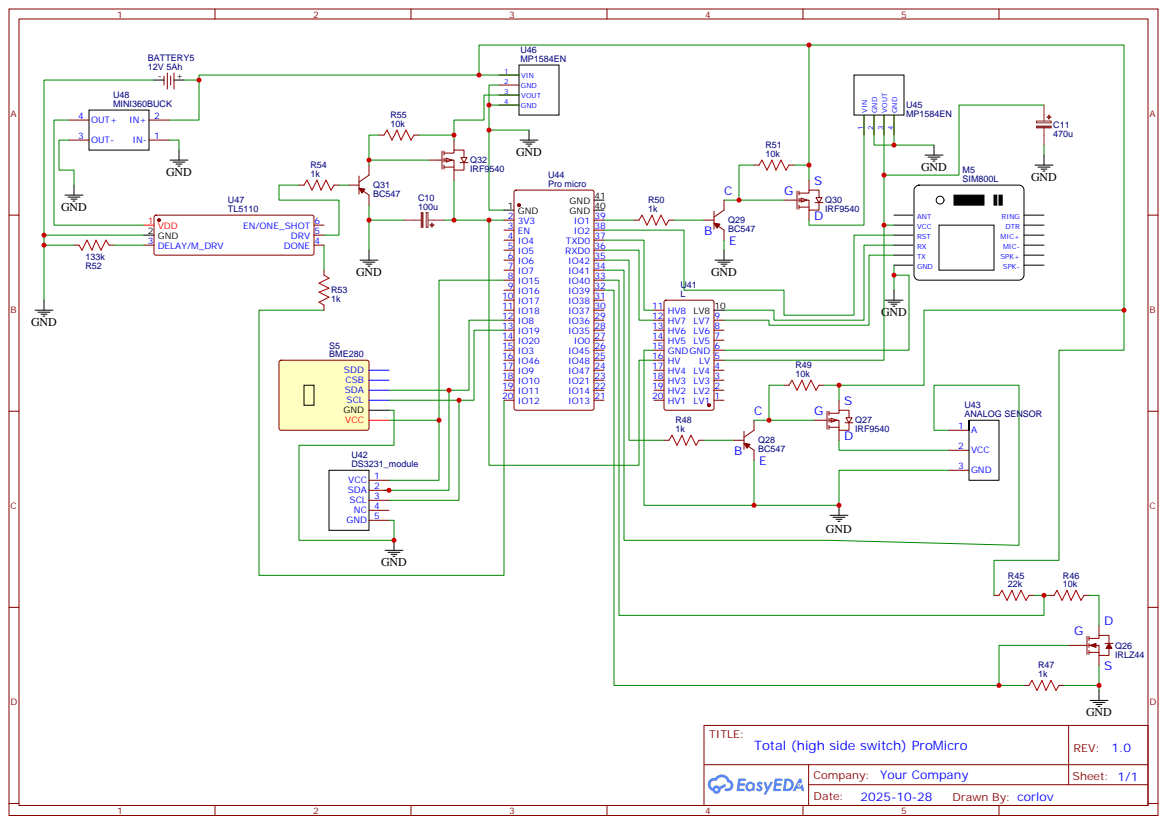
[picture p37: page 10]
