corlov/river-gauge/doc/schemas/easyeda/2025-11-07.pdf

## Battery 12v

5 Ah

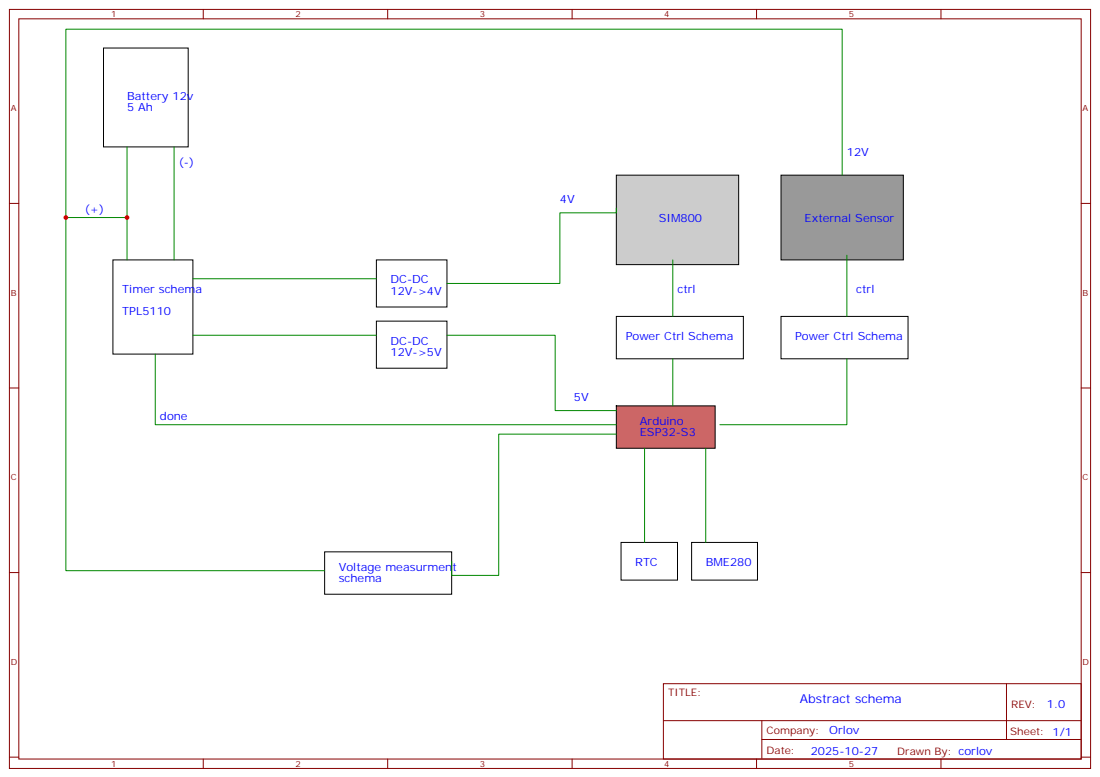
[picture p38: page 1]

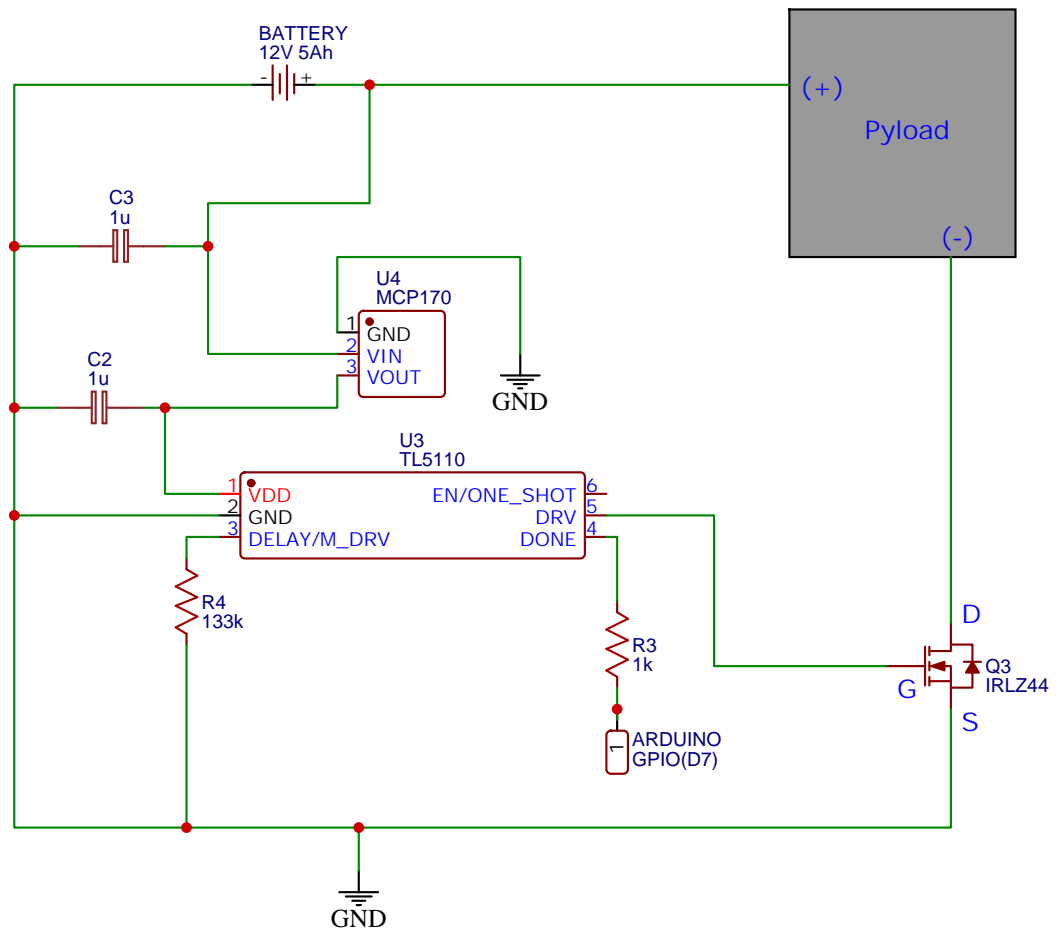
[picture p39: page 2]

S
G


## Battery (+12V)


(+)


D

C | G


# GND 5 gnd

D4184


TITLE:
Total with MOffset keys (more simple for manufacture)REV: 1.0

S
C | G

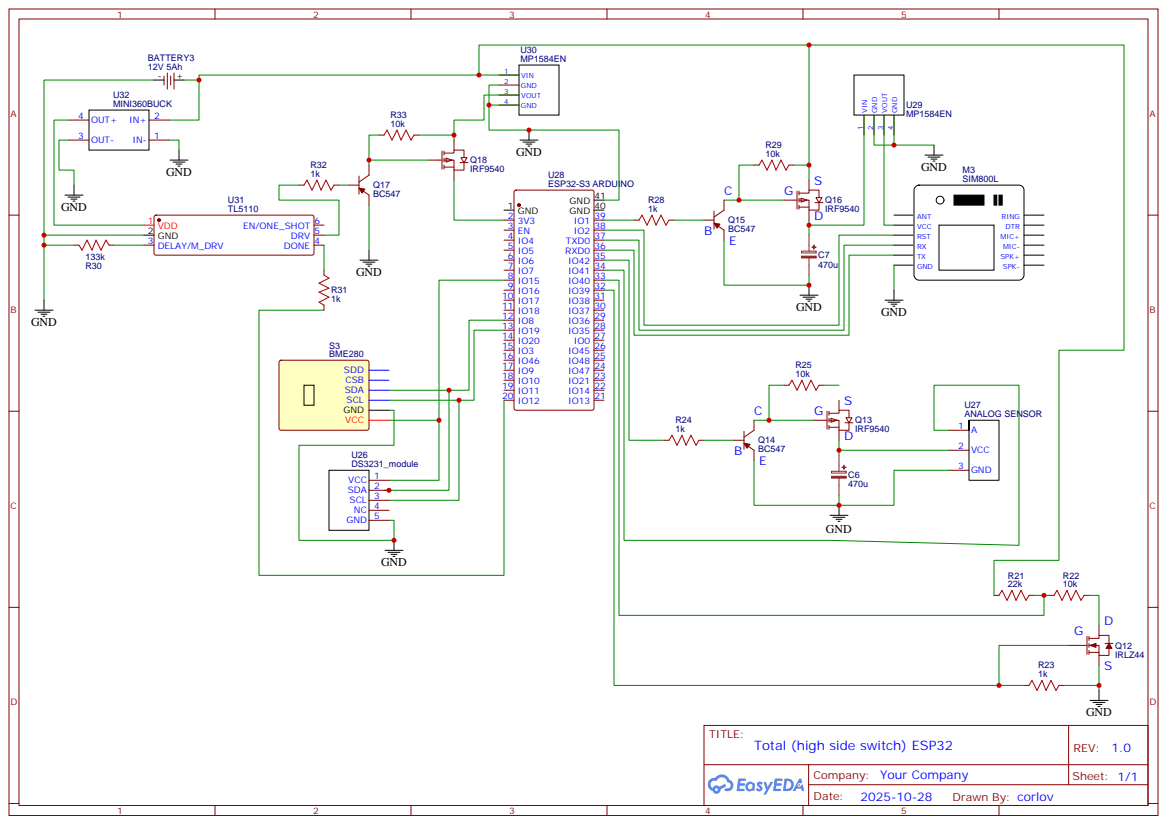
[picture p40: page 8]

C | G
