corlov/river-gauge/doc/schemas/easyeda/2025-11-03.pdf

## Battery 12v

5 Ah



S
G


## Battery (+12V)


(+)

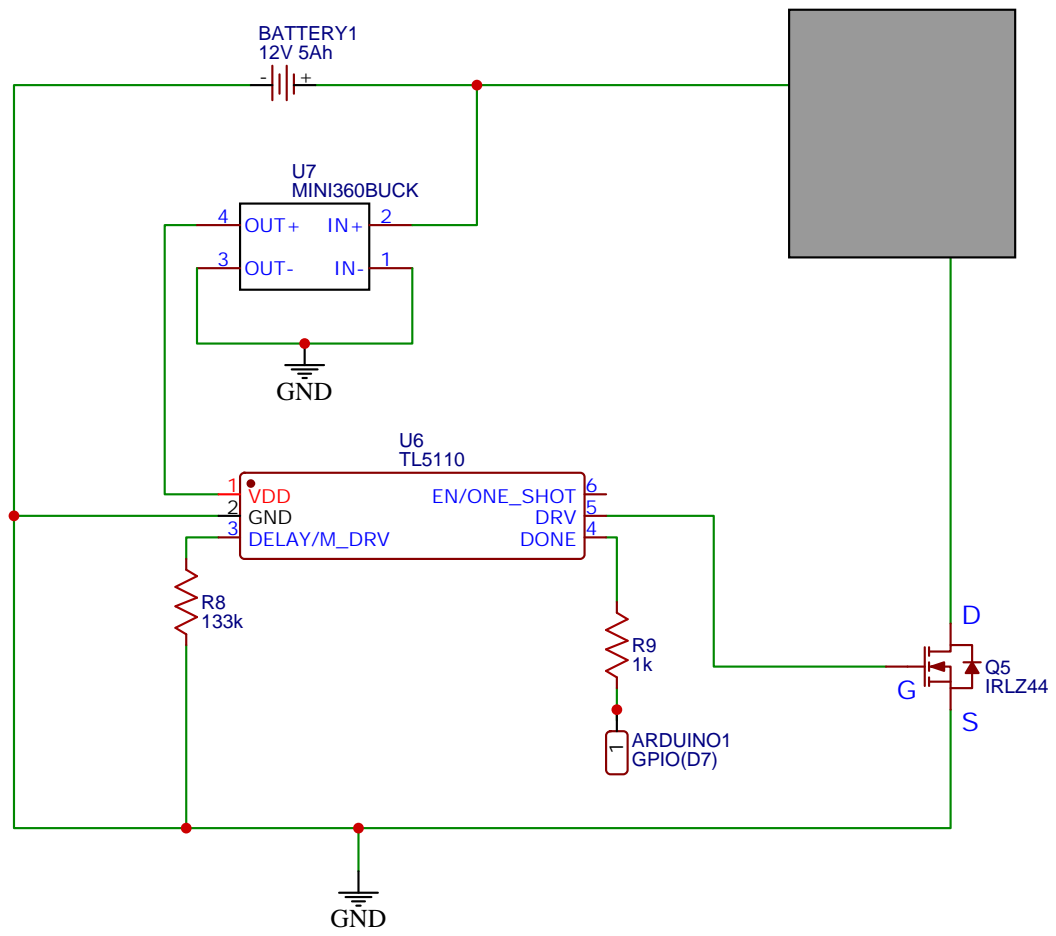
[picture p41: page 5]

D

C | G

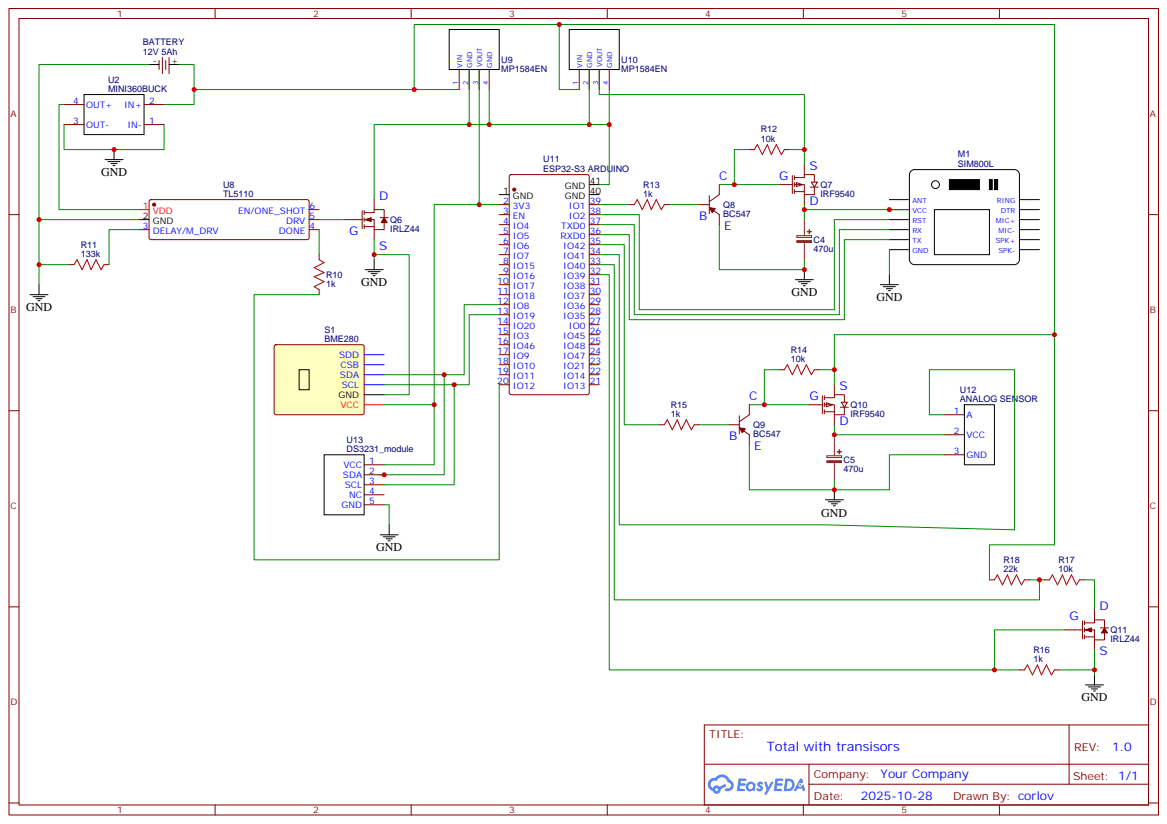
[picture p42: page 6]

# GND 5 gnd

D4184

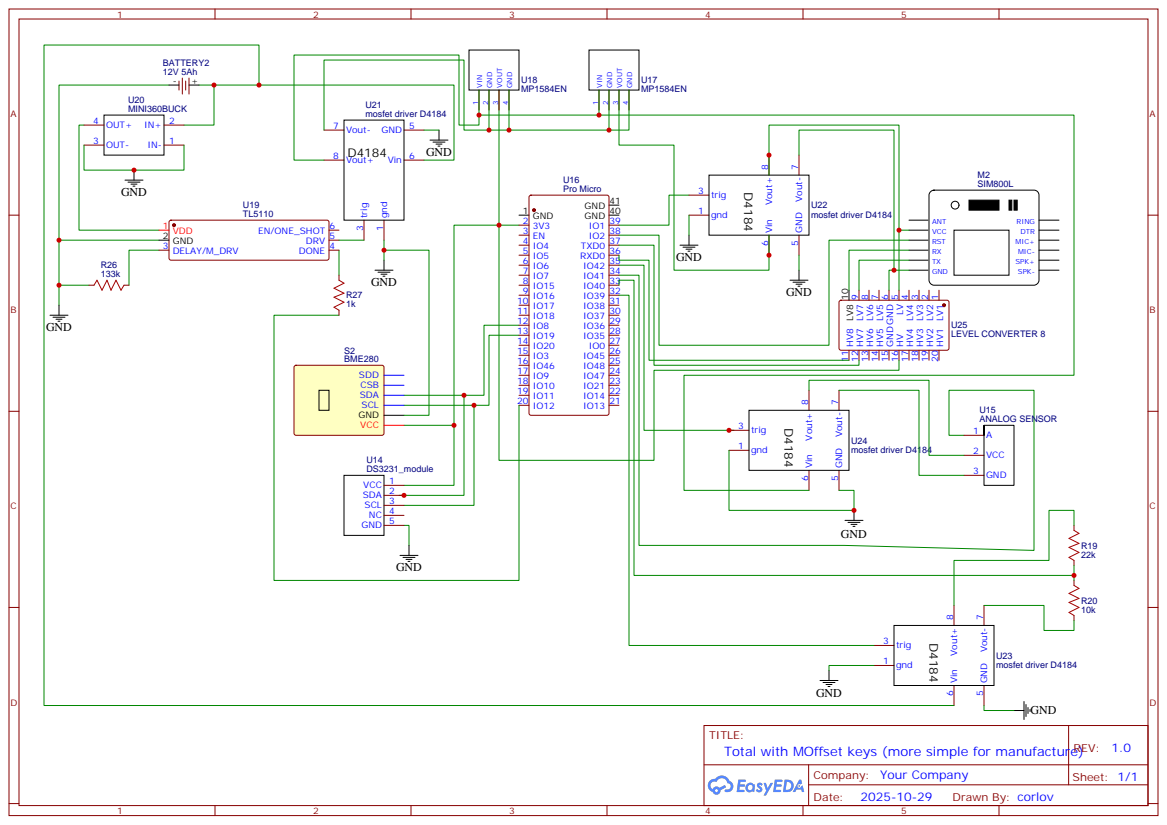
[picture p43: page 7]

TITLE:
Total with MOffset keys (more simple for manufacture)REV: 1.0

S
C | G

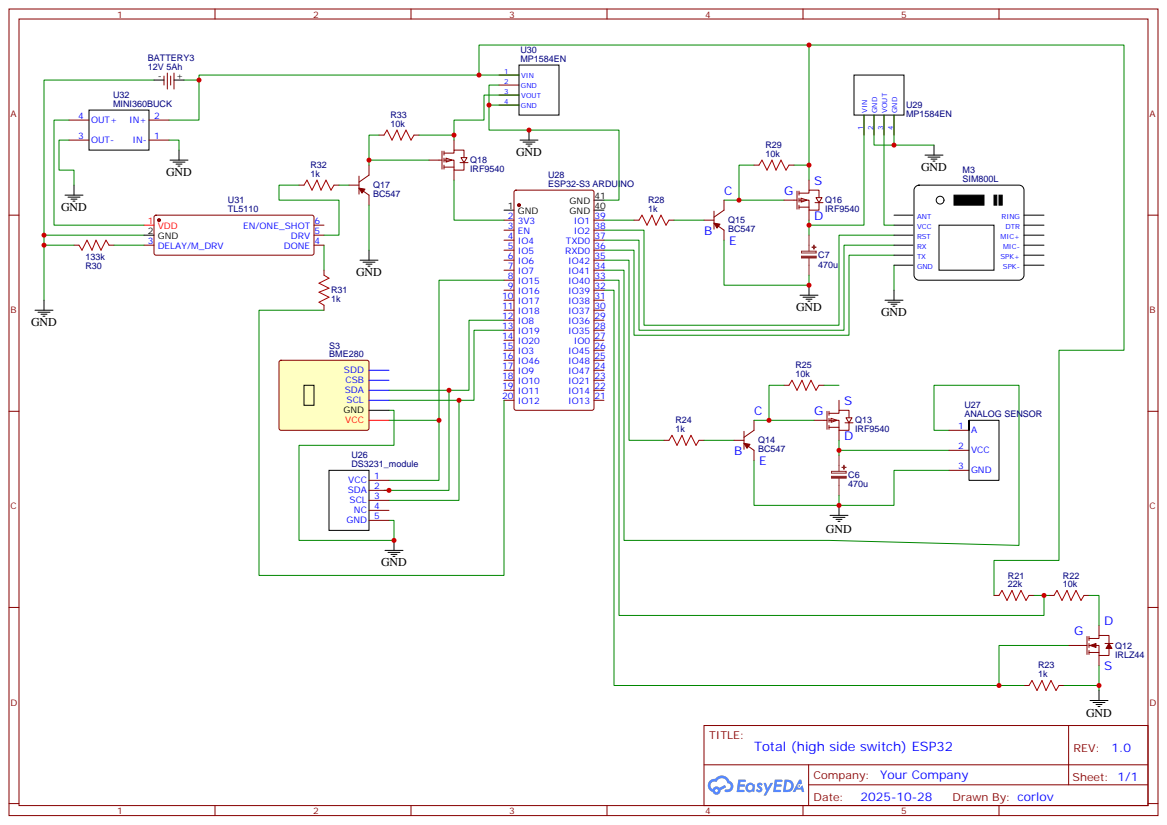
[picture p44: page 8]

C | G

S

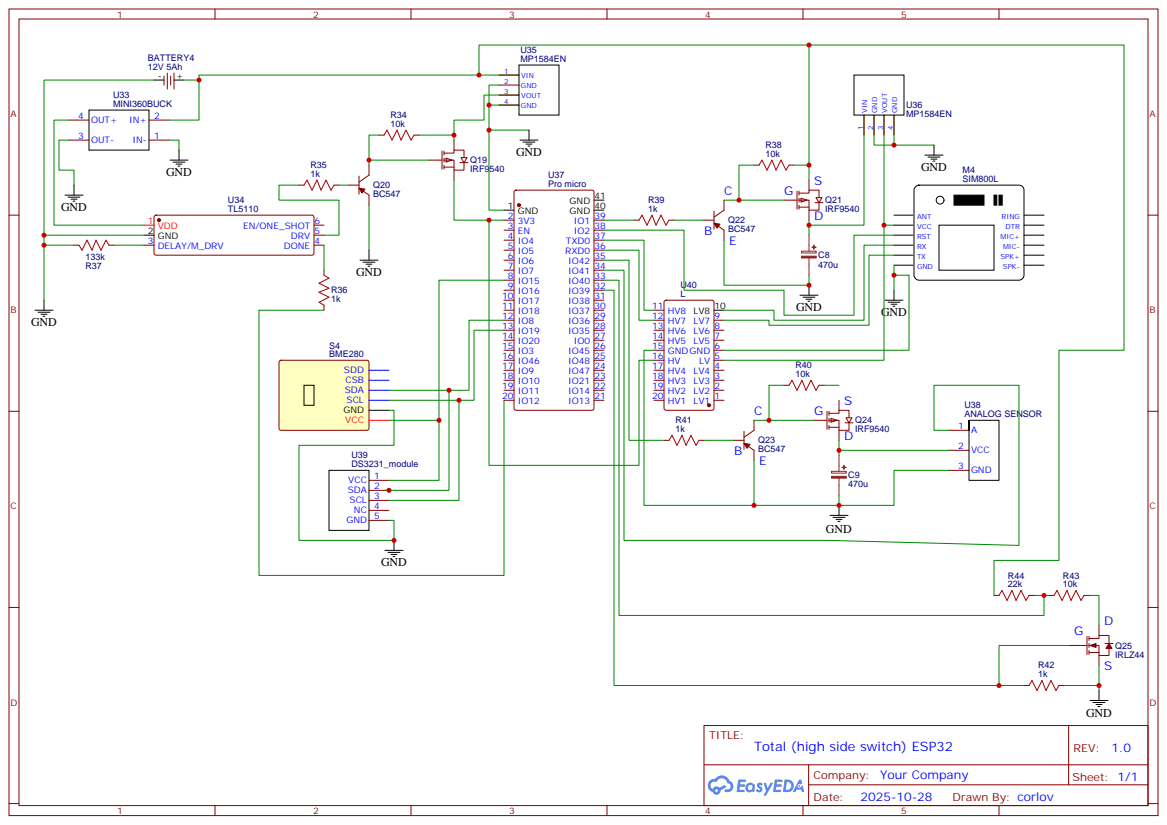
[picture p45: page 9]
