corlov/river-gauge/doc/schemas/easyeda/2025-10-29.pdf

## Battery 12v

5 Ah



S
G


## Battery (+12V)


(+)


D

C | G

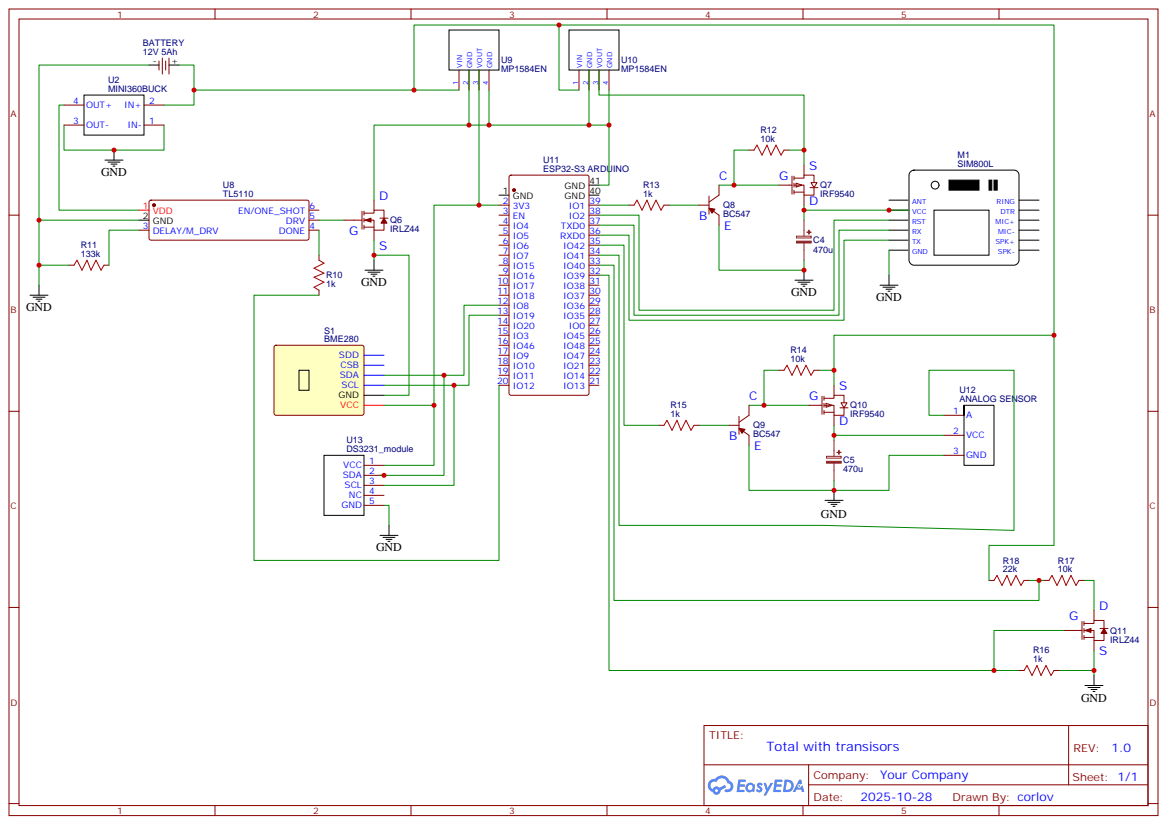
[picture p46: page 6]

# GND 5 gnd

D4184


TITLE:
Total with MOffset keys (more simple for manufacture)REV: 1.0
