corlov/river-gauge/doc/schemas/easyeda/2025-10-28_2.pdf

## Battery 12v

5 Ah

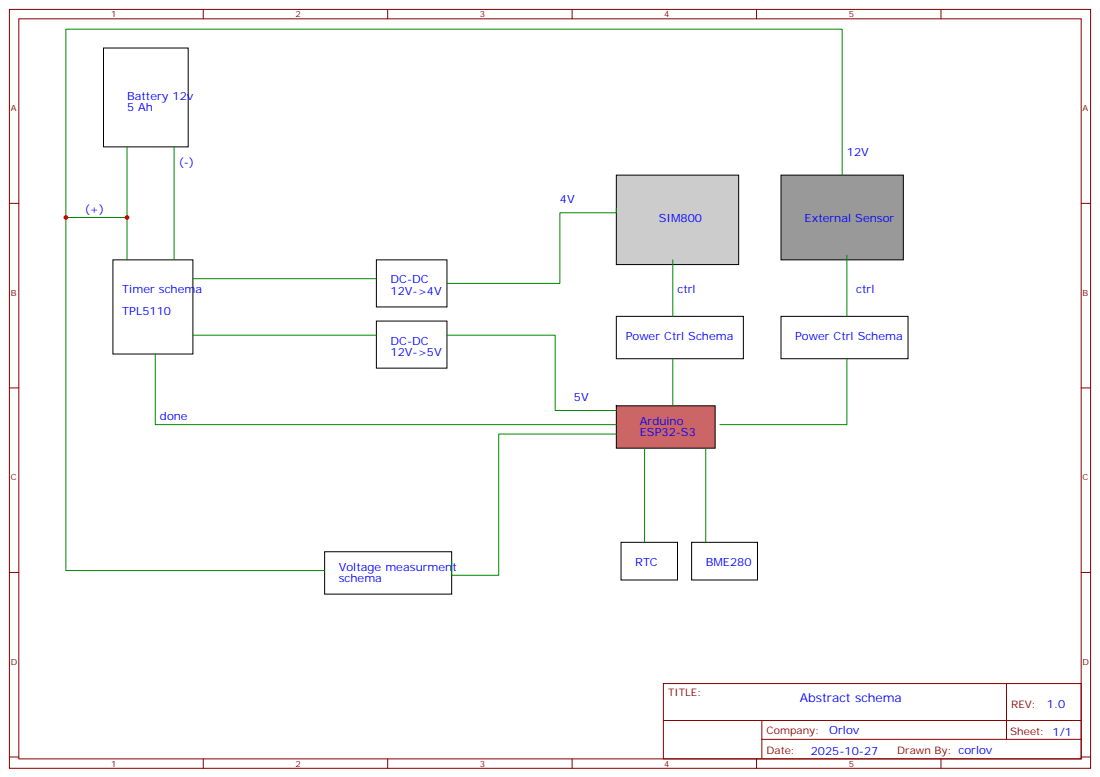
[picture p47: page 1]


S
G


## Battery (+12V)


(+)


D

C | G

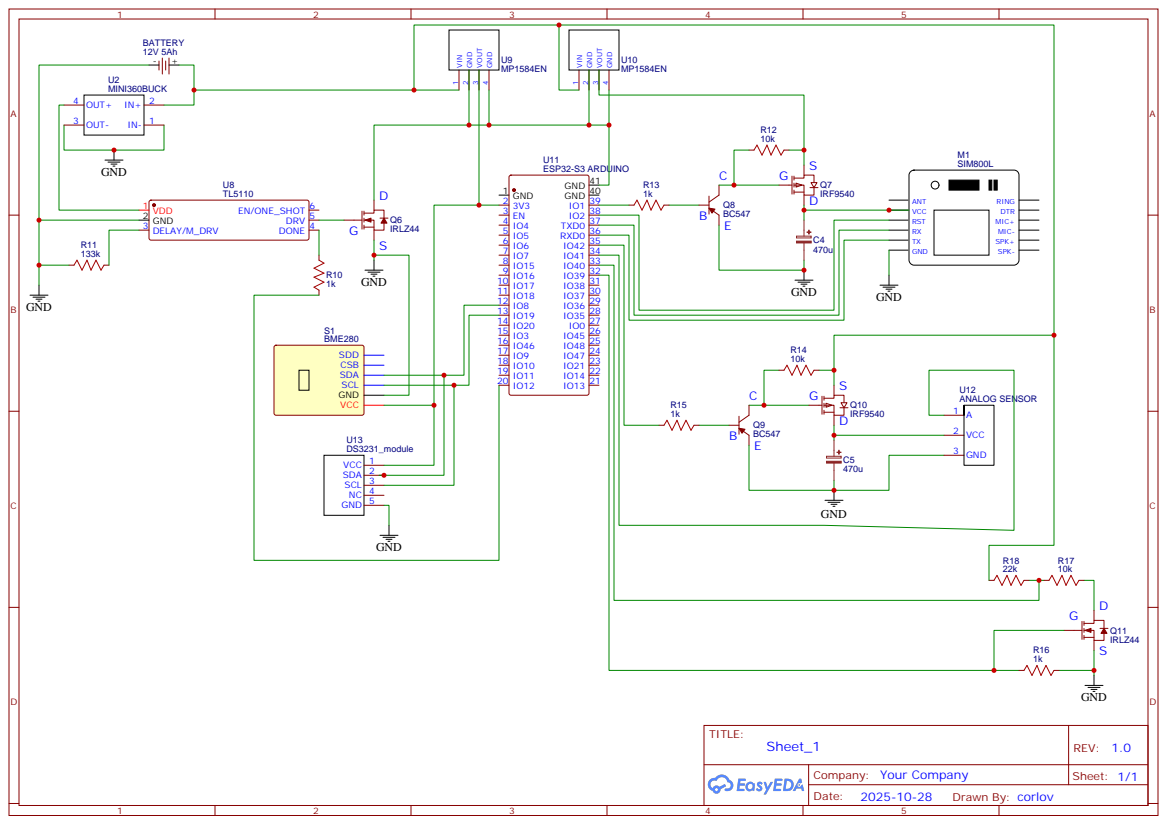
[picture p48: page 6]
