corlov/river-gauge/doc/schemas/easyeda/2025-10-28.pdf

## Battery 12v

5 Ah



S
G

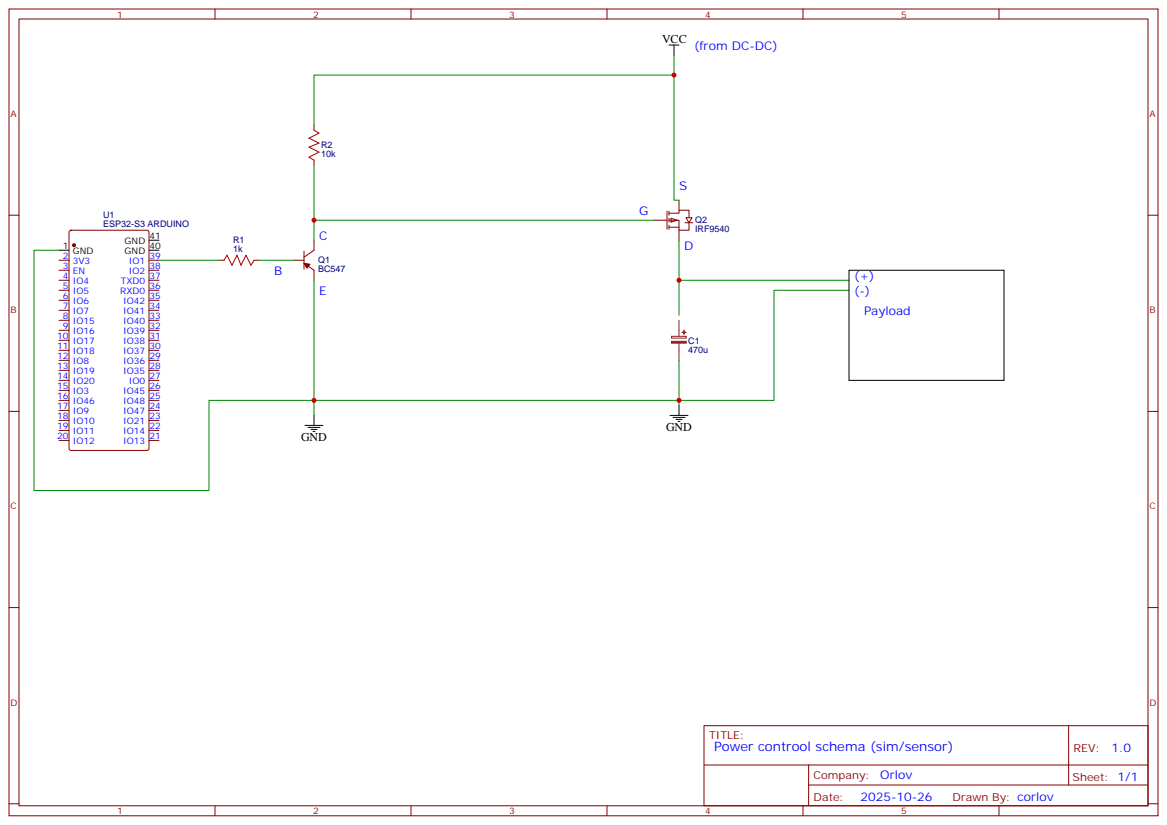
[picture p49: page 3]

## Battery (+12V)

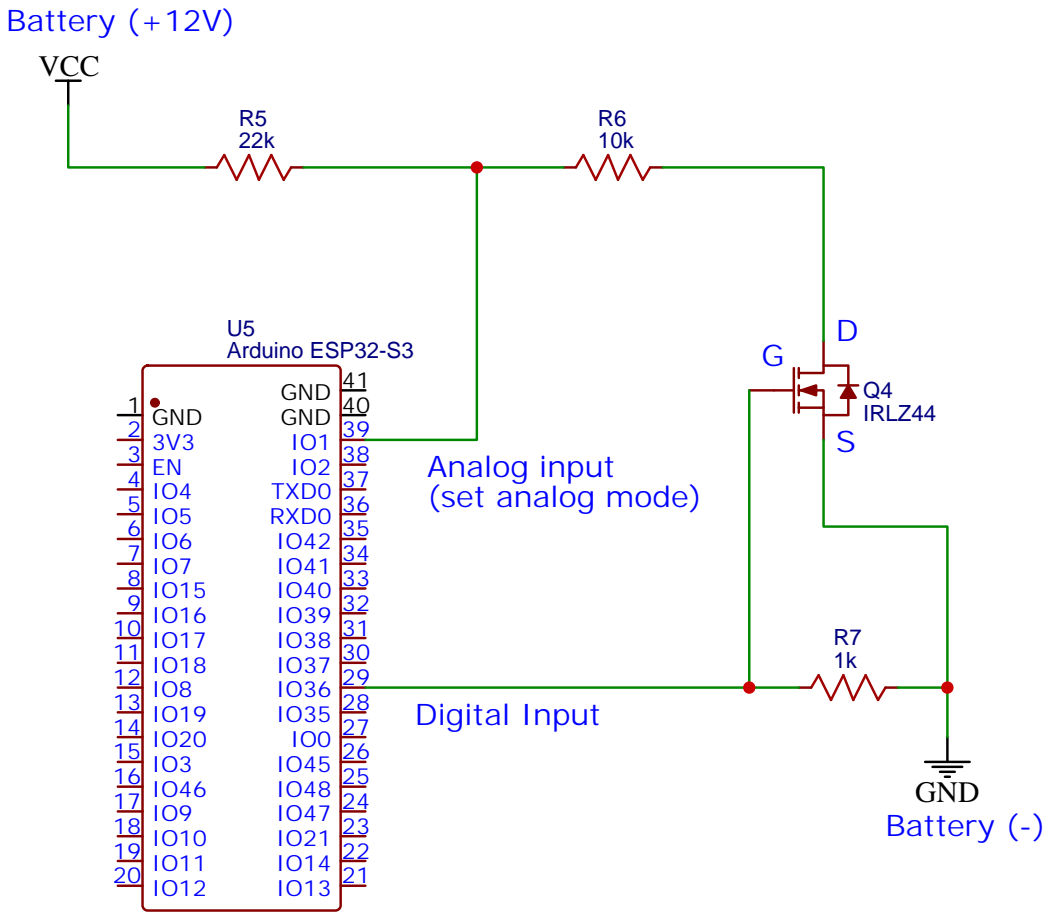
[picture p50: page 4]

(+)
