corlov/river-gauge/doc/schemas/easyeda/2025-10-27.pdf

SD
G

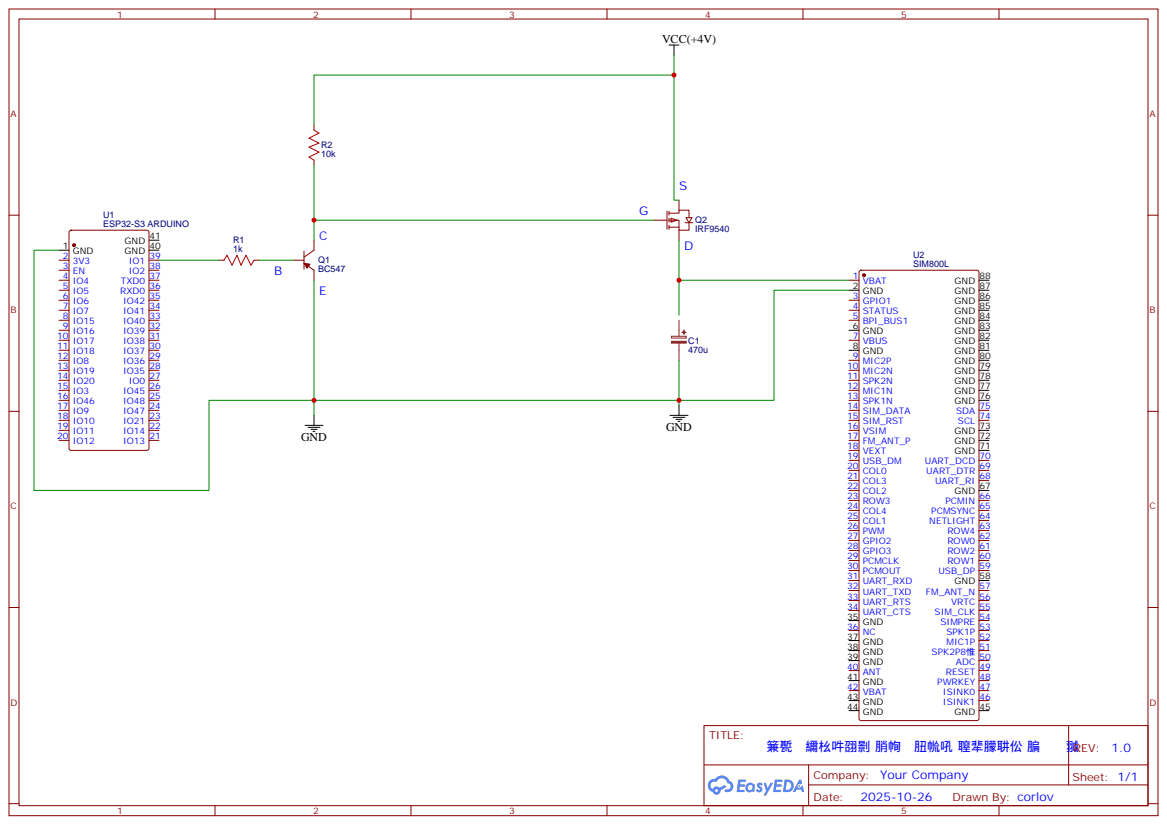
[picture p51: page 1]

SIM800L
51 MIC1P 52 SPK1P 53 SIMPRE 54 SIM_CLK 55 VRTC 56 FM_ANT_N 57 GND 58 USB_DP 59 ROW1 60 ROW2 61 ROW0 62 ROW4 63 NETLIGHT 64 PCMSYNC 65 PCMIN 66 GND 67 UART_RI 68 UART_DTR 69 UART_DCD 70 GND 71 GND 72 GND 73 SCL 74 SDA 75 GND 76 GND 77 GND 78 GND 79 GND 80 GND 81 GND 82 GND 83 GND 84 GND 85 GND 86 GND 87 GND 88

䈴㽄а䌤㭃吽䎄㔀 䏴㡄␰䏔㡃吼 䏄㹃䑃䎴伀 䐔㉄䎀REV: 1.0

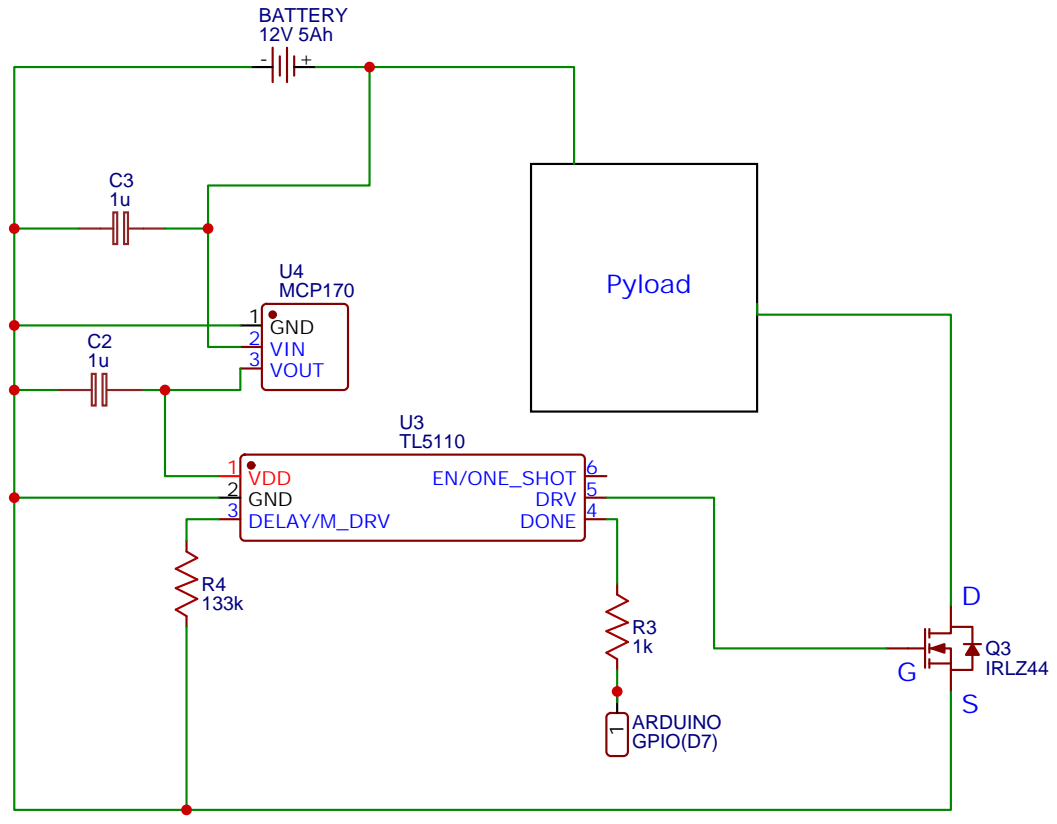
[picture p52: page 2]

## BME281

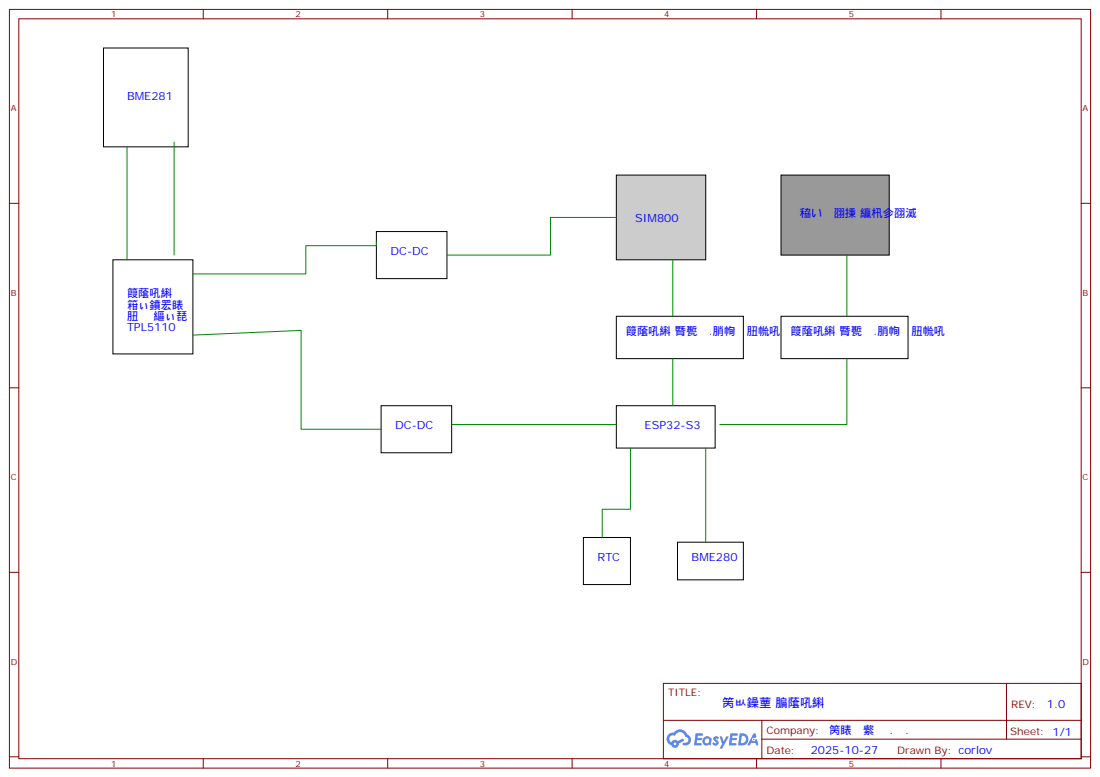
[picture p53: page 3]

䈔䕃吼䌀 䐴㽄.䏴㡄␰䏔㡃吼
