corlov/river-gauge/doc/schemas/easyeda/16-02-2026/Schematic_HydroStation-14-02-2026_2026-02-16.pdf

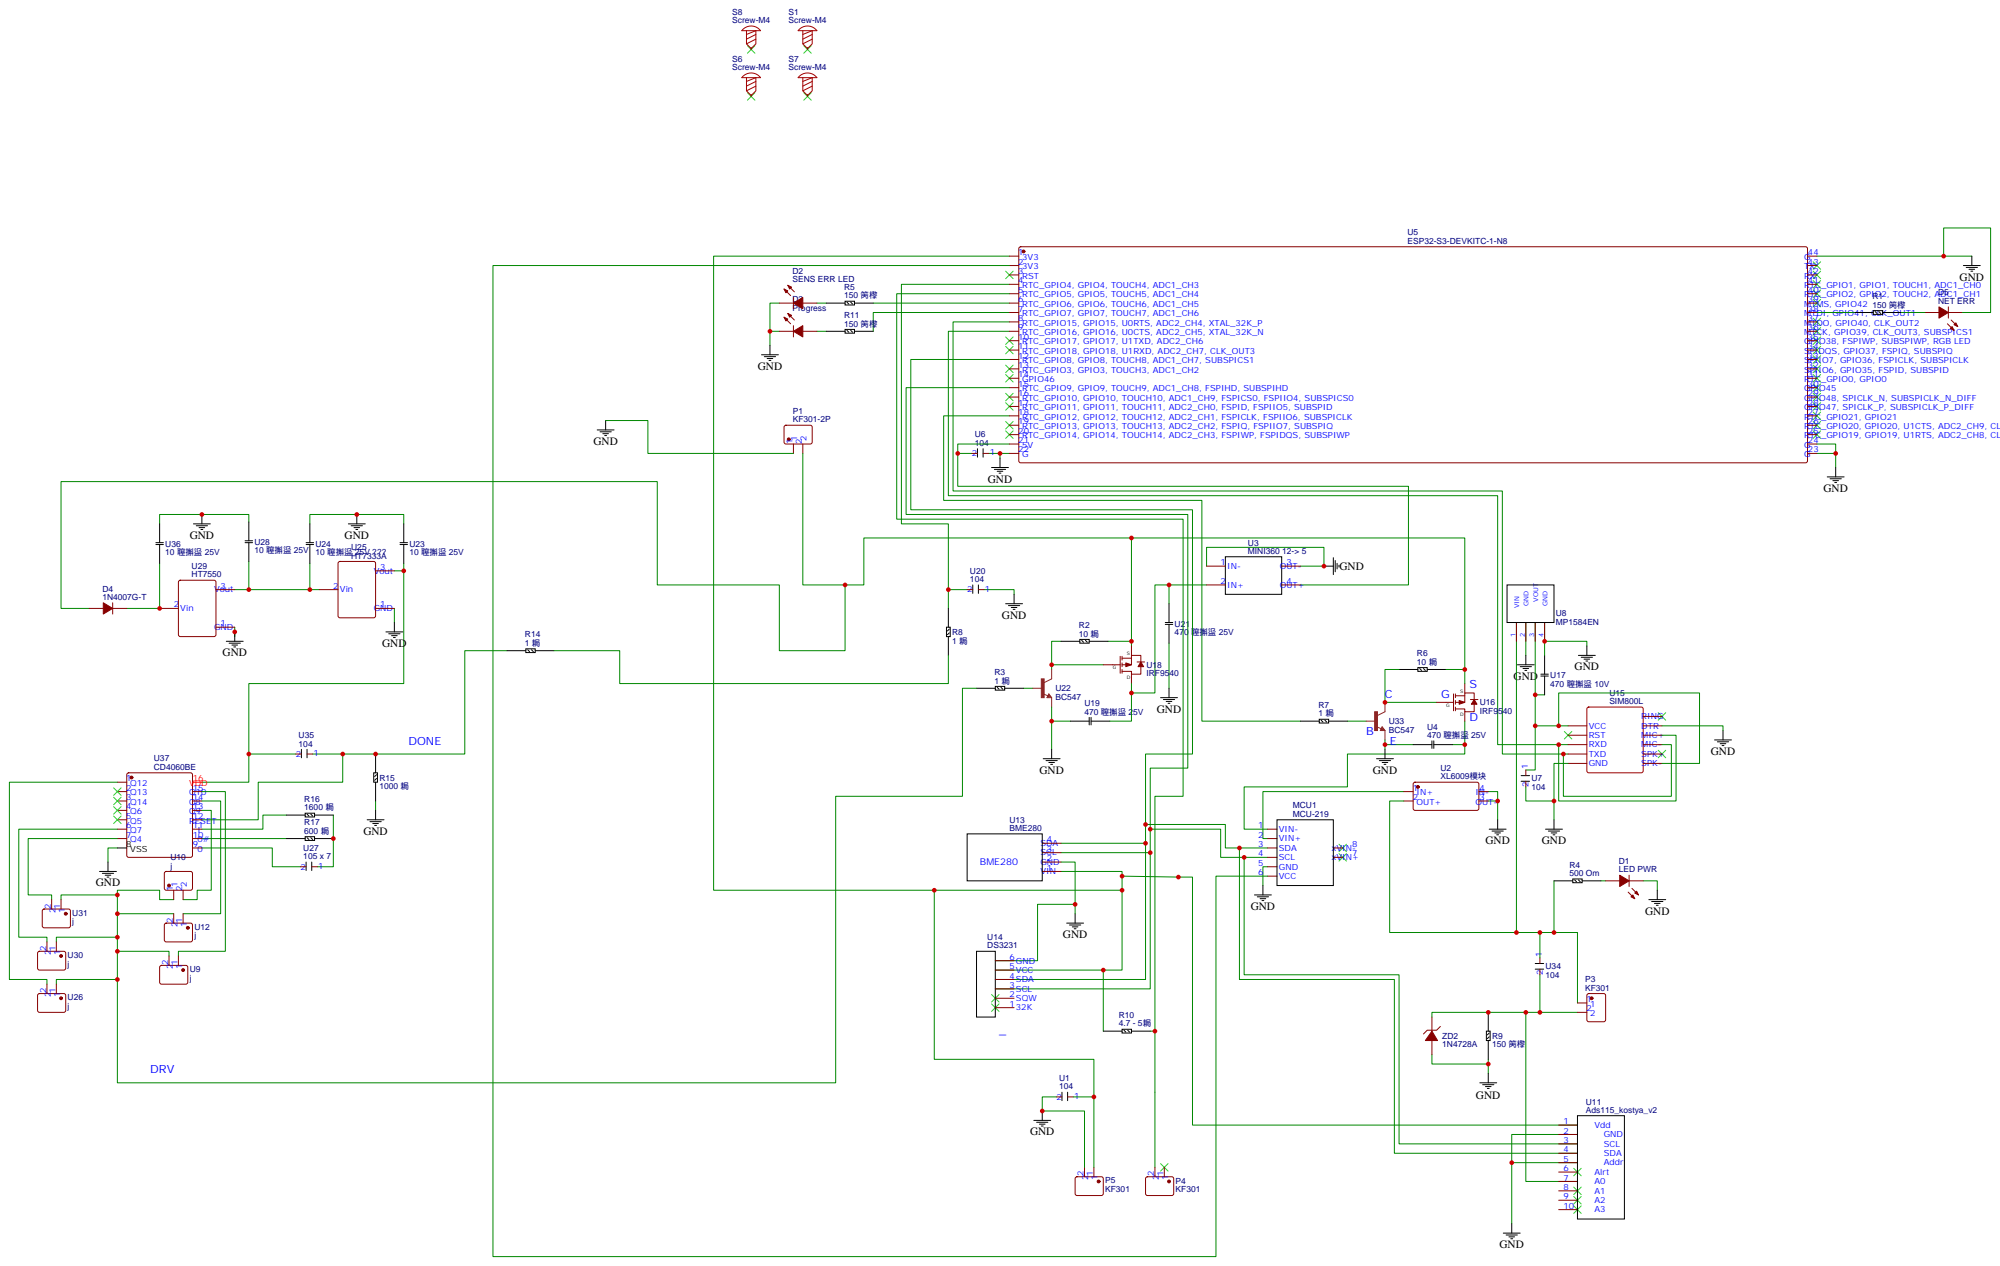
[picture p54: page 1]
