corlov/river-gauge/doc/schemas/easyeda/timer_23-01-2026/Schematic_cd4060_timer_2026-01-23 (1).pdf

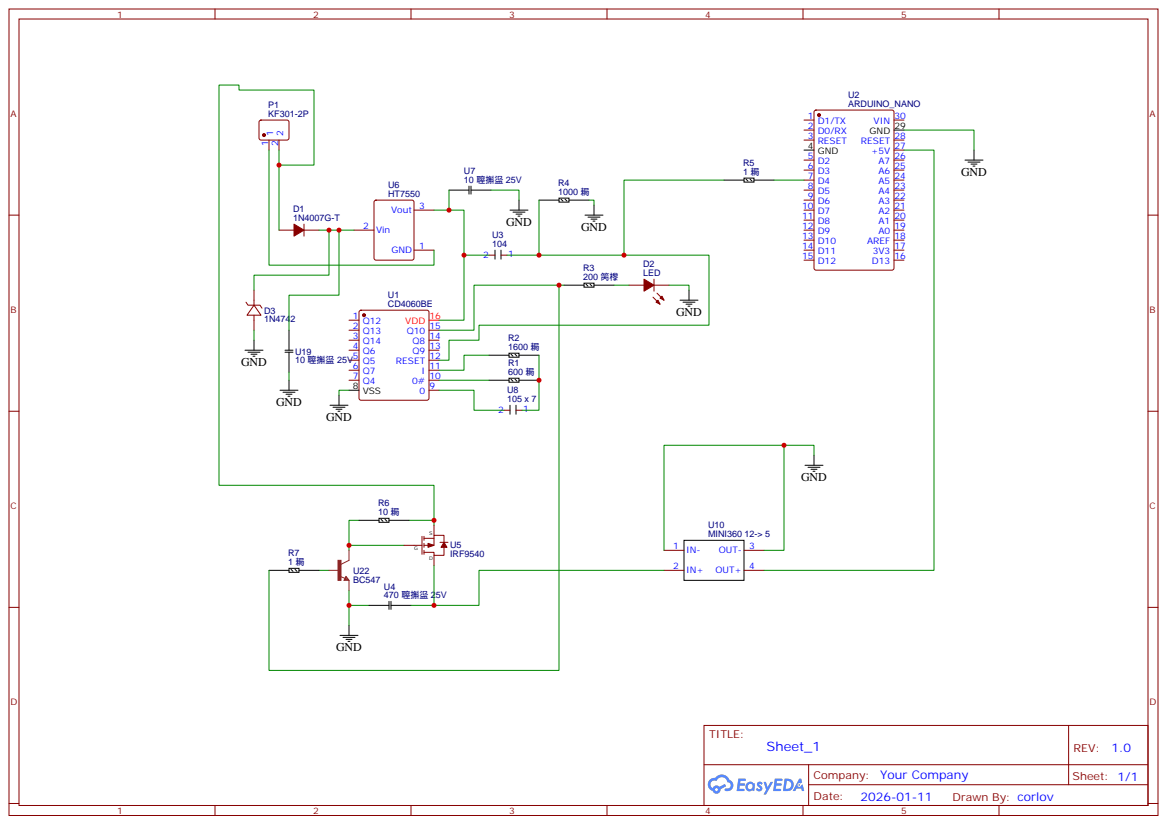
[picture p55: page 1]

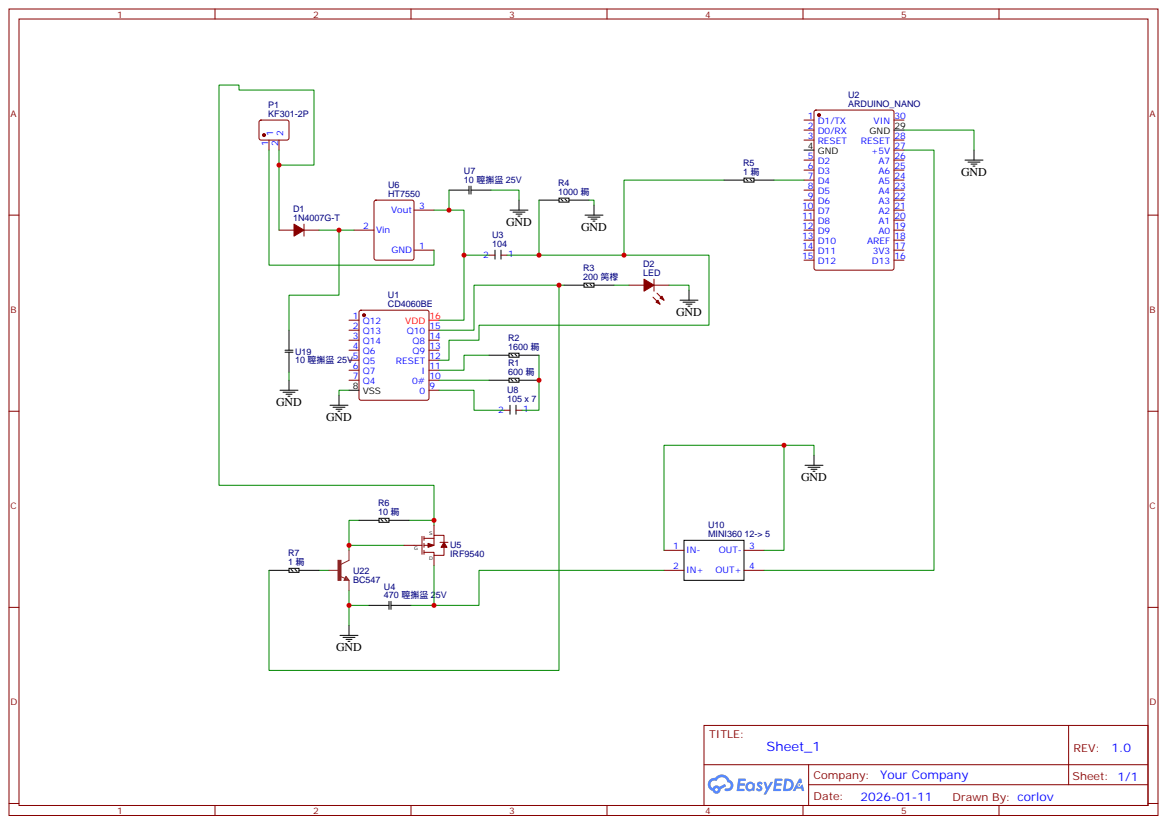
[picture p56: page 2]

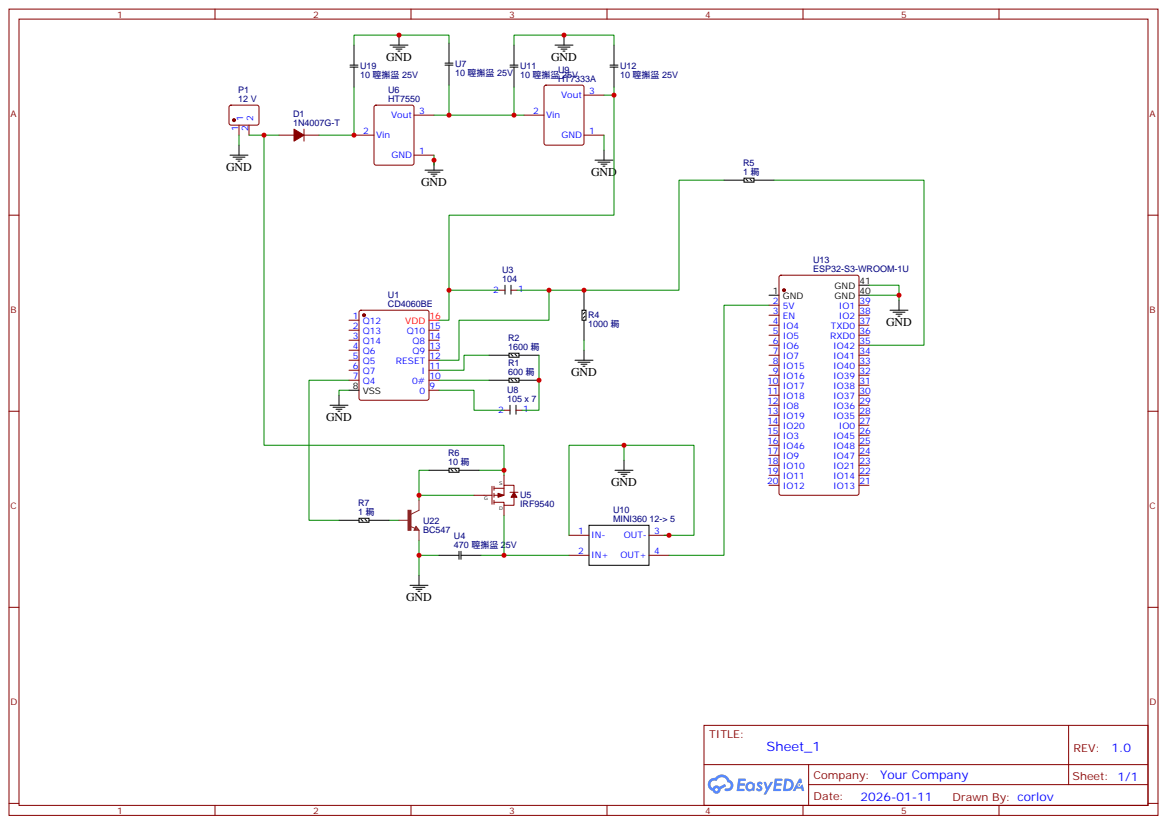
[picture p57: page 3]
