corlov/river-gauge/doc/schemas/easyeda/09-11-2025/Schematic_Project2_2025-11-09.pdf

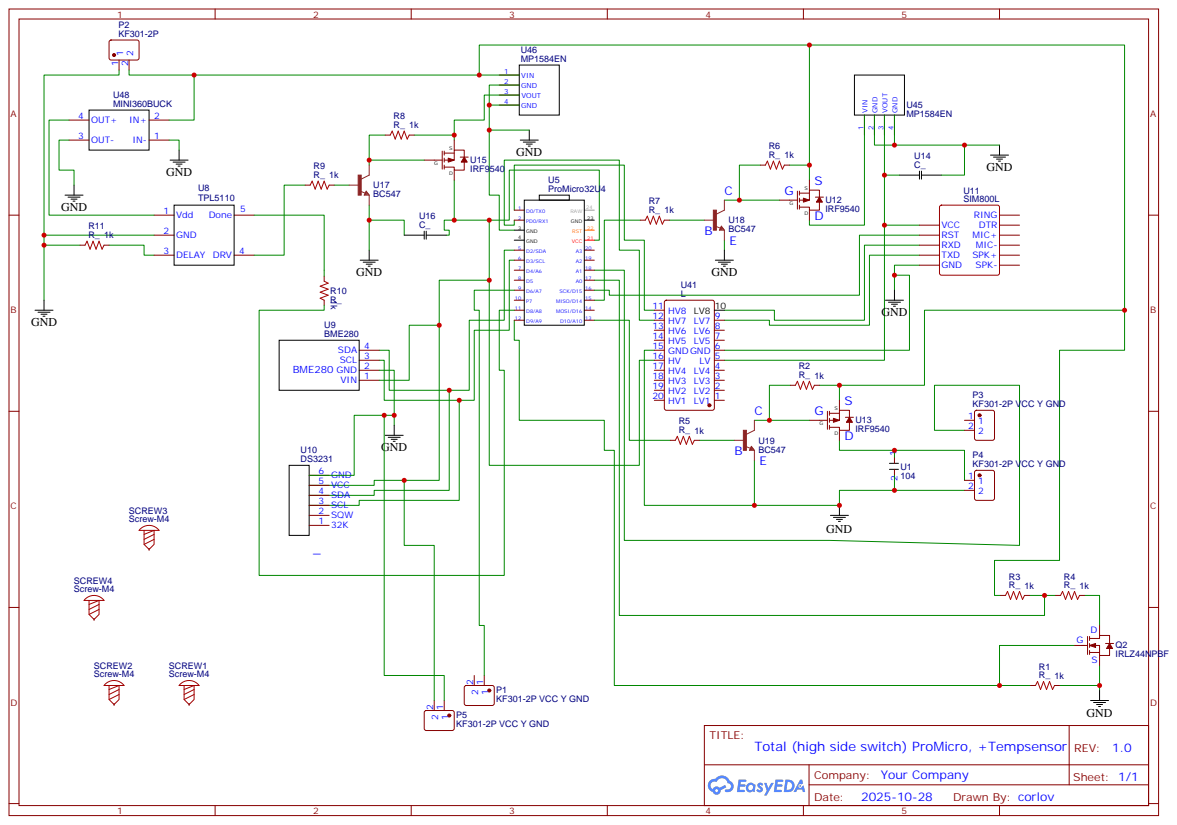
[picture p58: page 1]
