corlov/river-gauge/doc/schemas/easyeda/18-11-2025/Schematic_Project2_2025-11-12.pdf

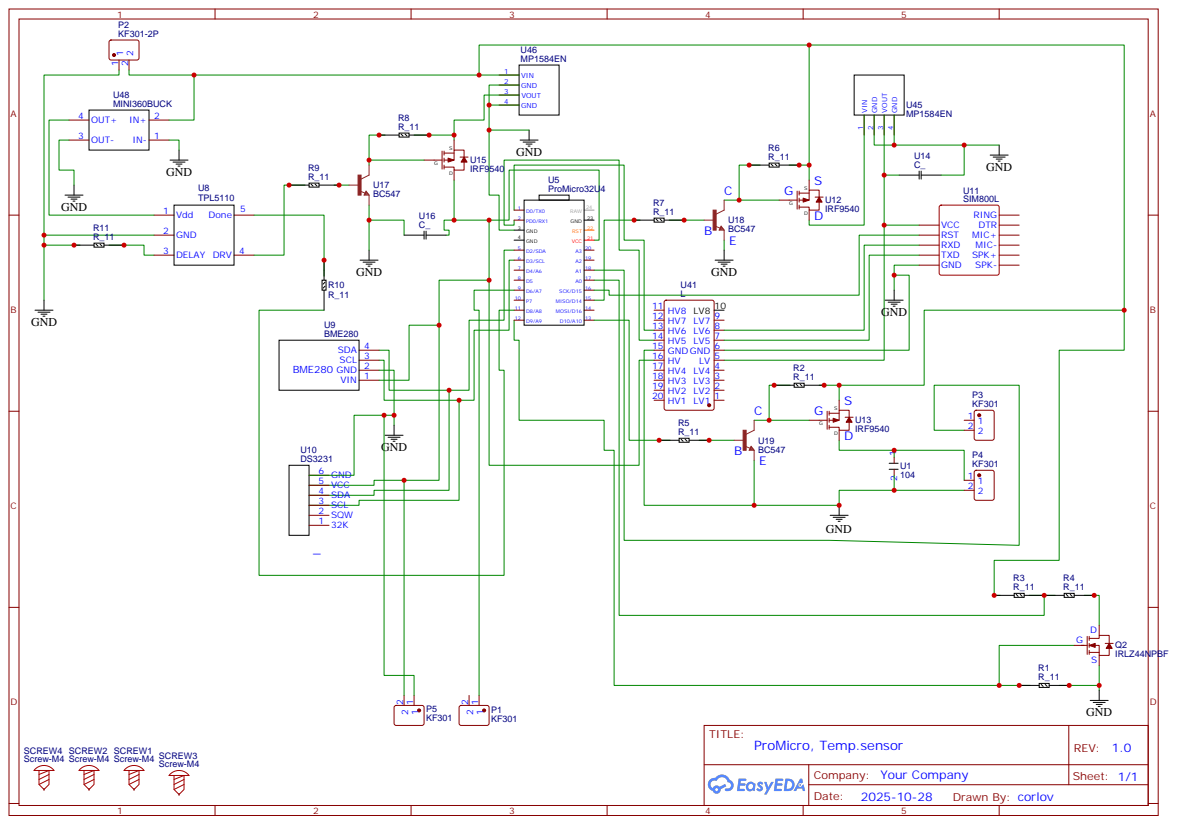
[picture p59: page 1]

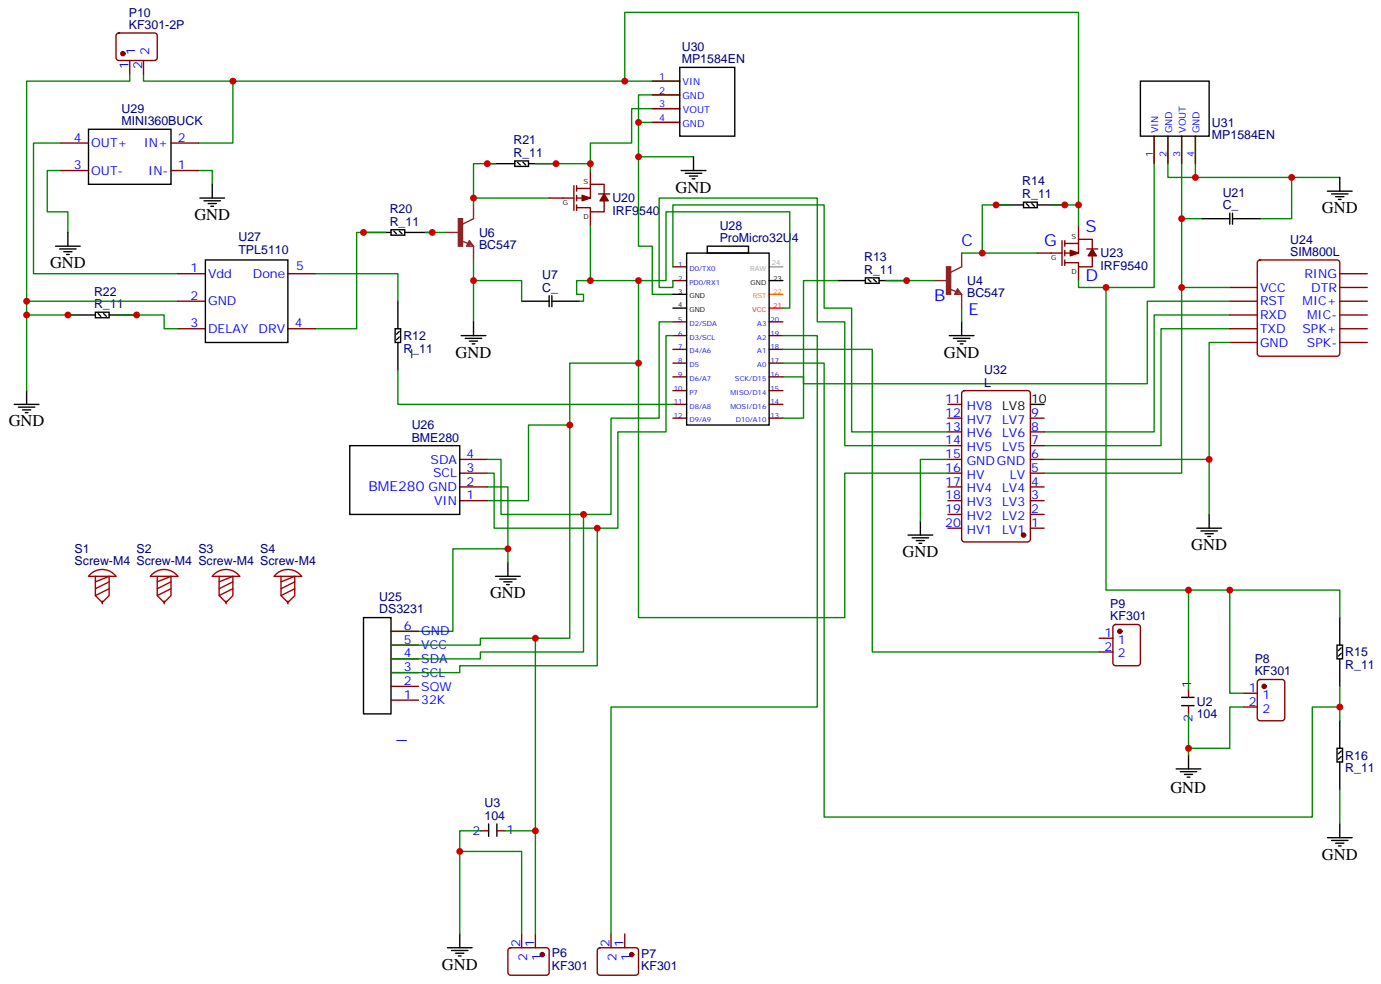
[picture p60: page 2]
