corlov/river-gauge/doc/schemas/easyeda/18-11-2025/Schematic_ProMicro_evo2_2025-11-12.pdf

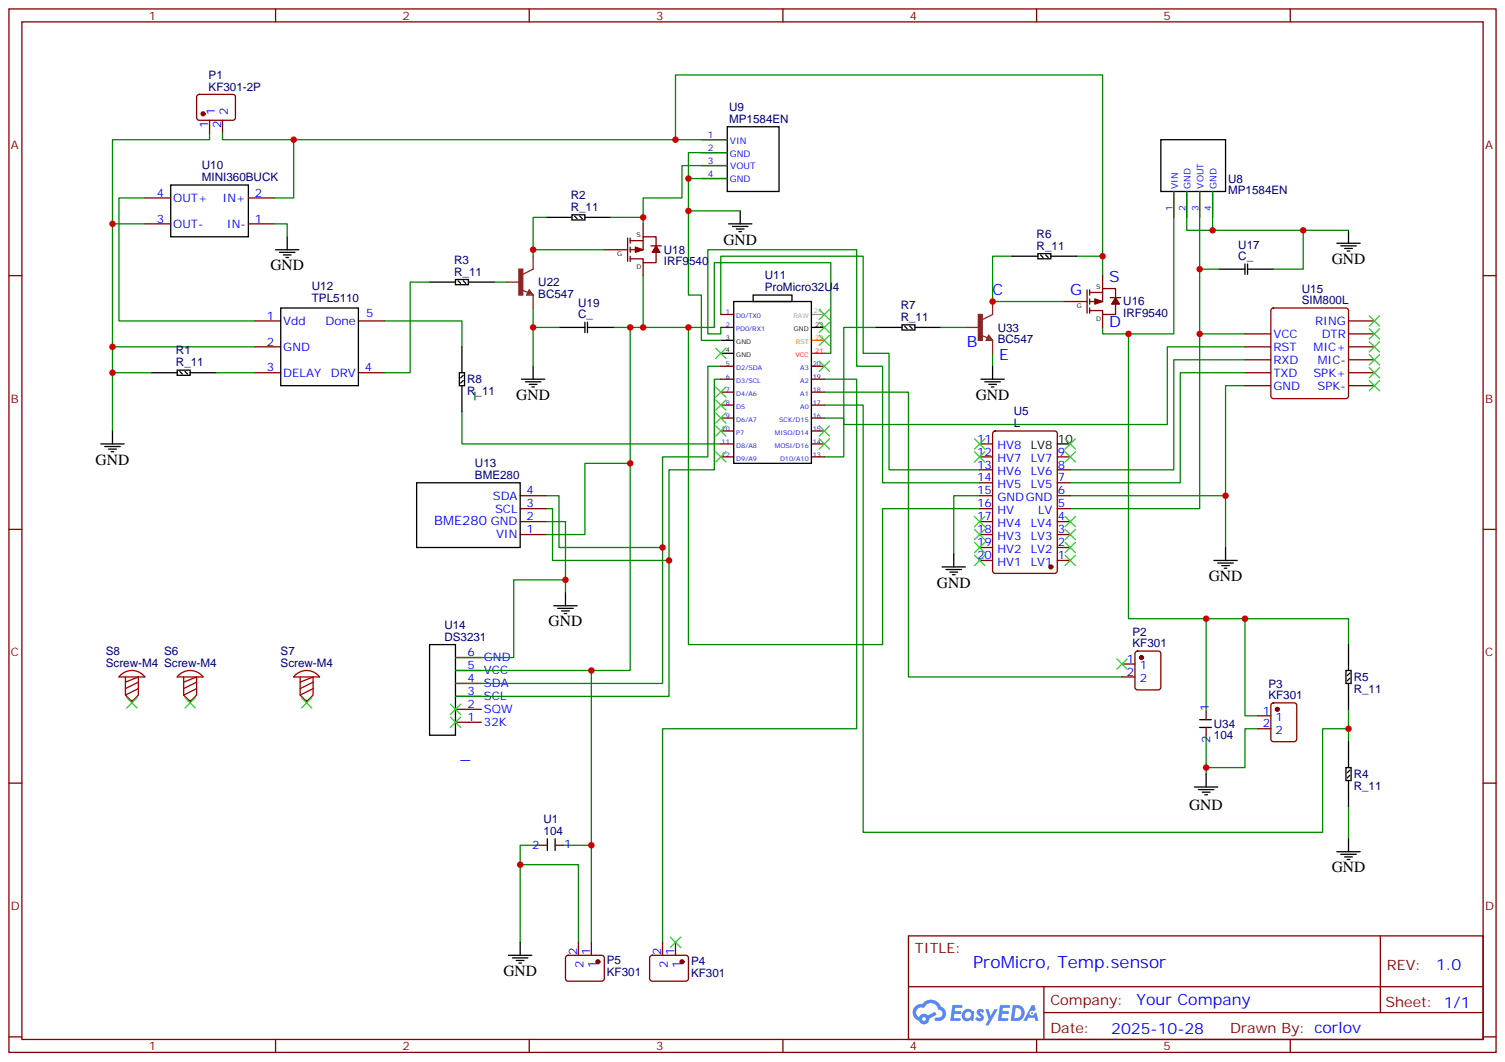
[picture p61: page 1]
