corlov/river-gauge/doc/schemas/easyeda/18-11-2025/Schematic_ProMicro_evo2_v2_2025-11-15.pdf

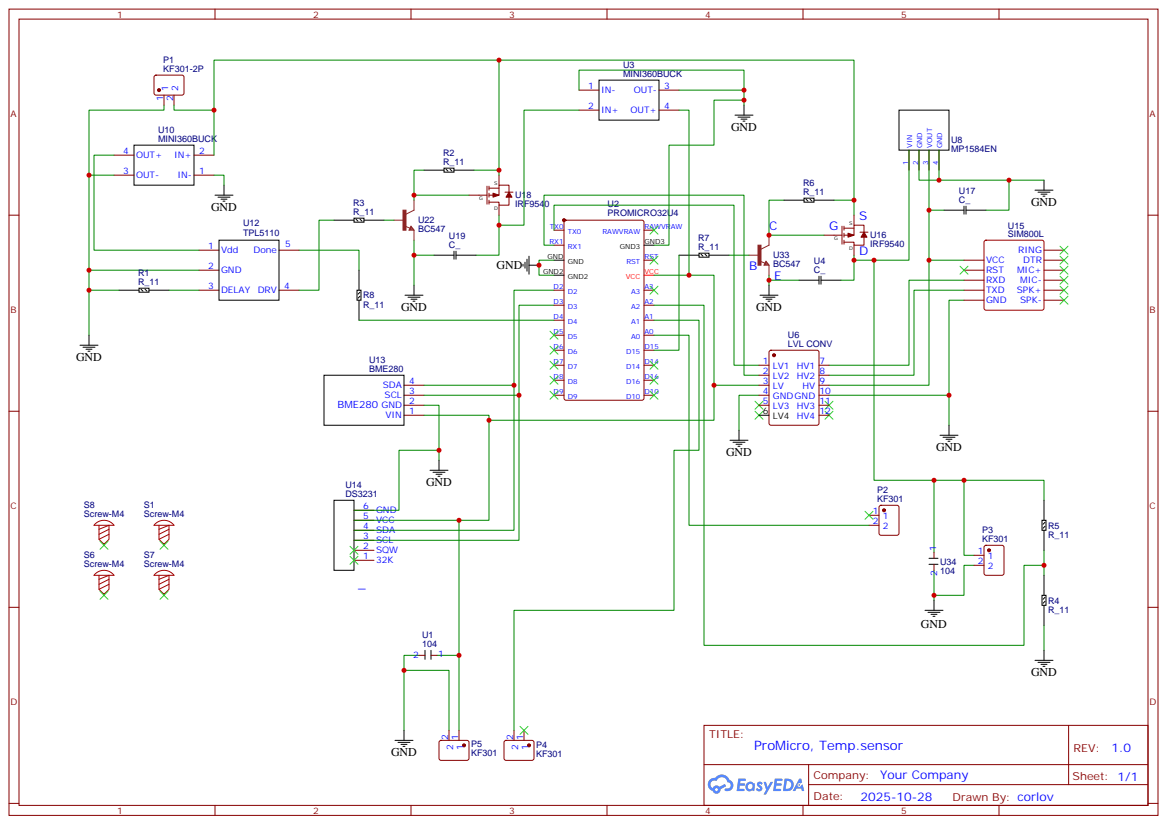
[picture p62: page 1]
