corlov/river-gauge/doc/schemas/easyeda/16-02-2026/PCB_PCB_HydroStation-14-02-2026_3_2026-02-16.pdf

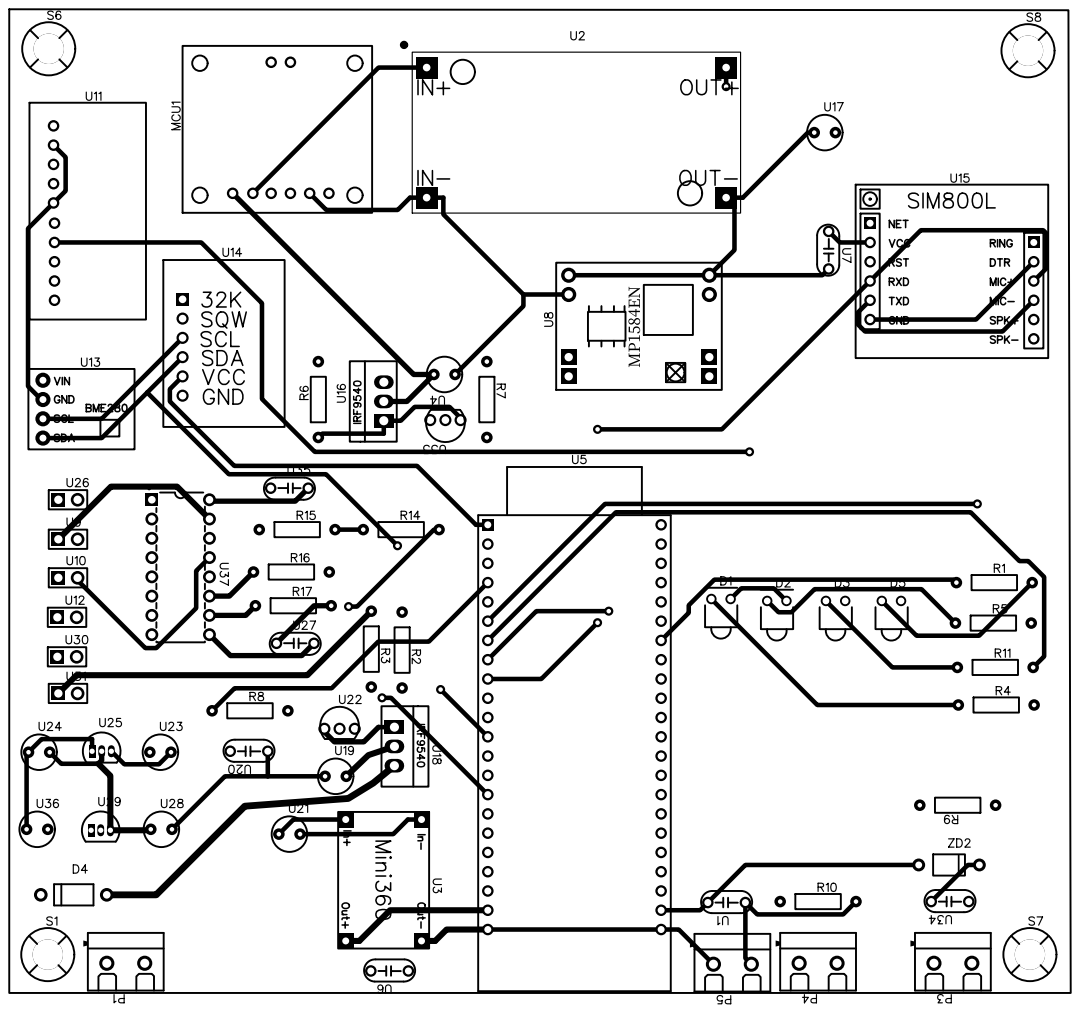
[picture p63: page 1]
