corlov/river-gauge/doc/schemas/easyeda/19-11-2025/PCB_PCB_ESP32-v1_3_2025-11-18.pdf

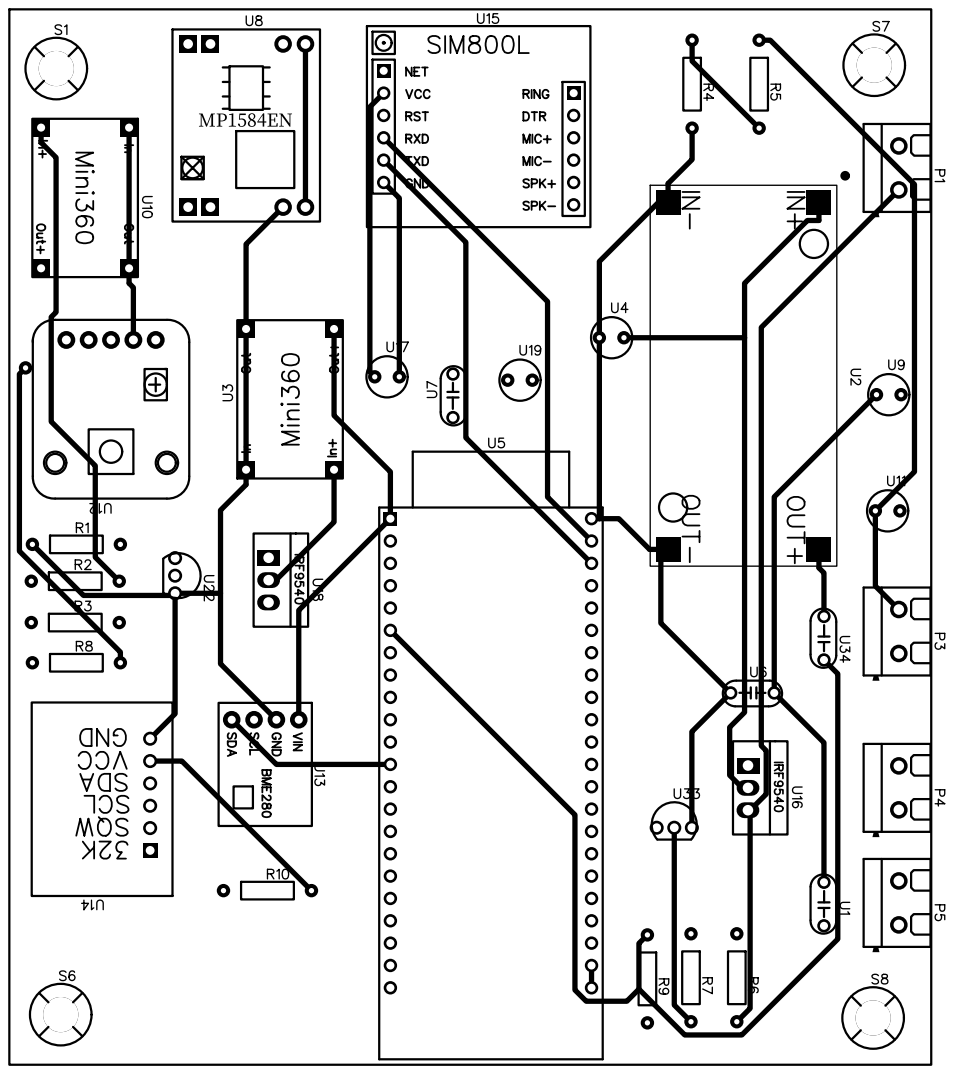
[picture p64: page 1]
