corlov/river-gauge/doc/schemas/easyeda/09-11-2025/PCB_PCB_Project2_9_2025-11-09 (1).pdf

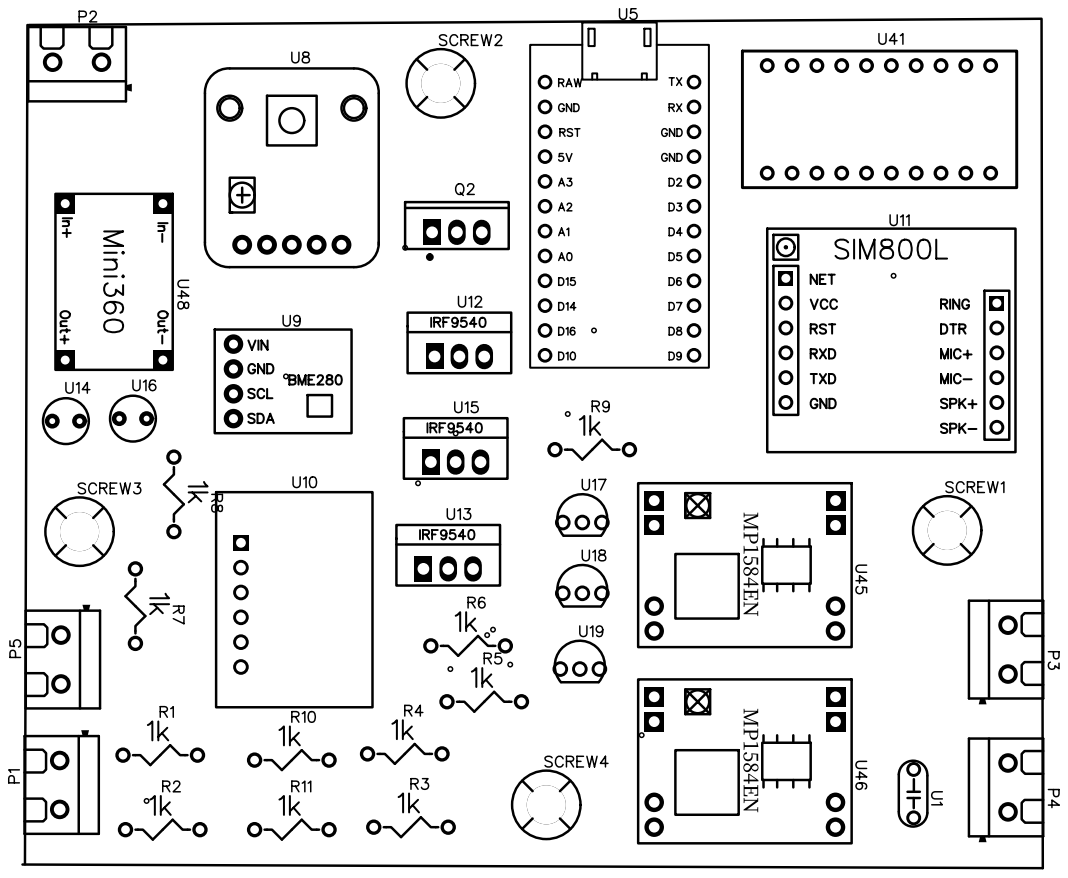
[picture p65: page 1]
