corlov/river-gauge/doc/schemas/easyeda/18-11-2025/PCB_PCB_ProMicro_evo2_2025-11-12.pdf

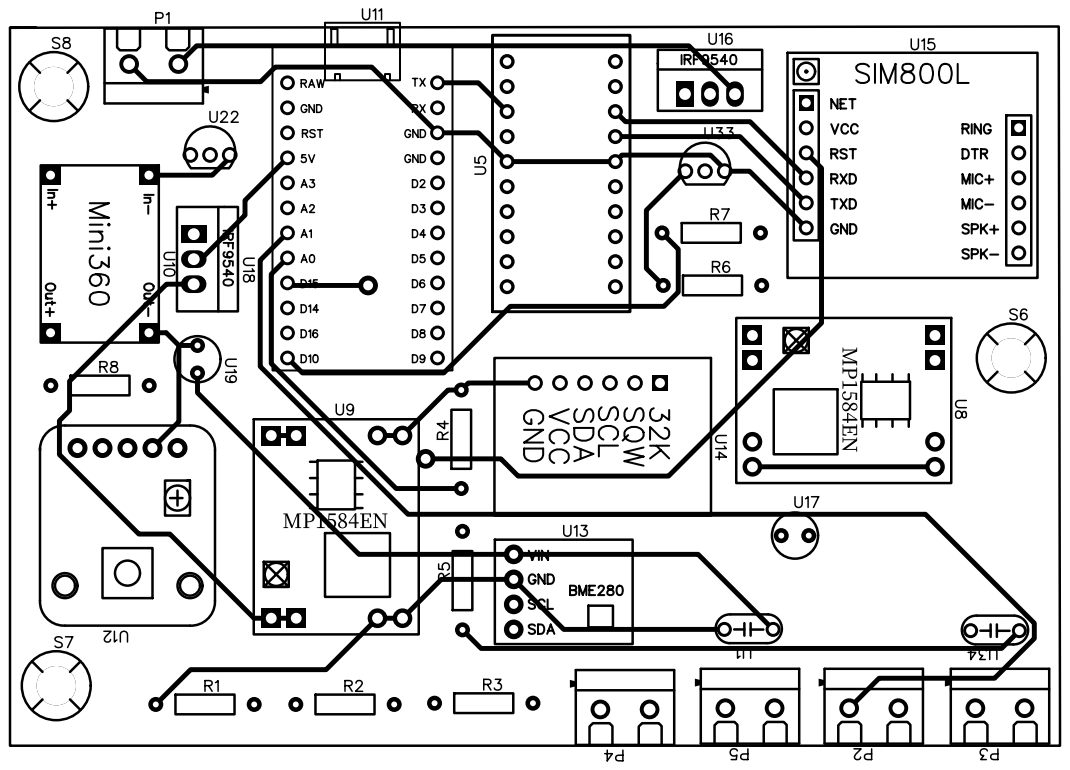
[picture p66: page 1]
