corlov/river-gauge/doc/schemas/easyeda/18-11-2025/PCB_PCB_ProMicro_evo2_2025-11-13.pdf

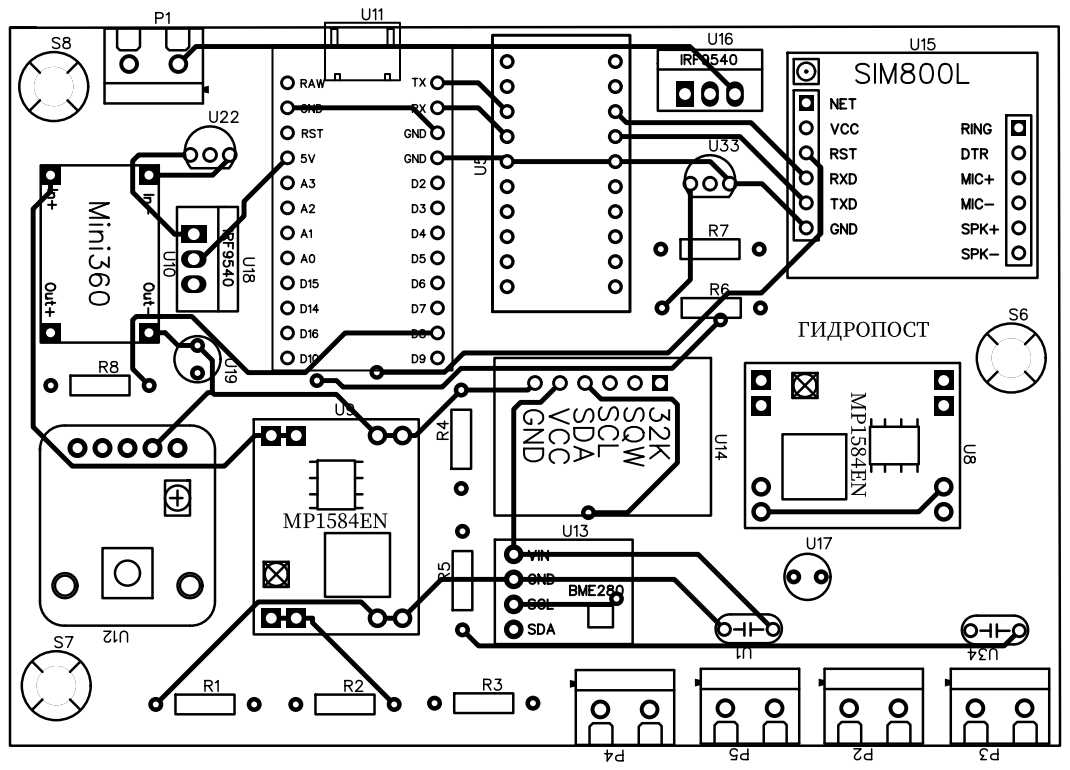
[picture p67: page 1]
