corlov/river-gauge/doc/schemas/easyeda/18-11-2025/PCB_PCB_ProMicro_evo2_v2_3_2025-11-15.pdf

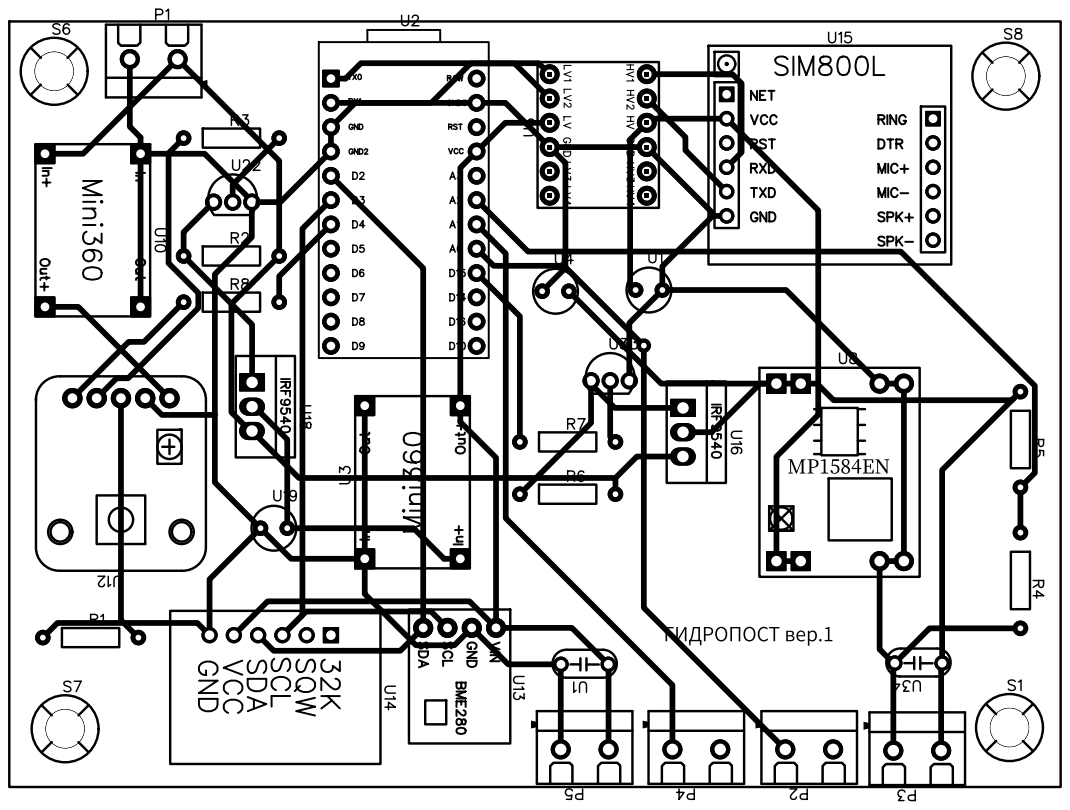
[picture p68: page 1]
