corlov/river-gauge/(list of files, drawings)

Other design files:
doc/schemas/easyeda/03-12-2025/Electrical_2025-12-03.schdoc
doc/schemas/easyeda/03-12-2025/PCB_PCB_ESP32-v3_01-12-2025_2.1_2025-12-03.json
doc/schemas/easyeda/03-12-2025/SCH_ESP32-v3_01-12-2025_2025-12-03.json
doc/schemas/easyeda/09-11-2025/PCB_PCB_Project2_9_2025-11-09.json
doc/schemas/easyeda/09-11-2025/SCH_Project2_2025-11-09.json
doc/schemas/easyeda/16-02-2026/Main_2026-02-16.schdoc
doc/schemas/easyeda/16-02-2026/PCB_PCB_HydroStation-14-02-2026_3_2026-02-16.json
doc/schemas/easyeda/16-02-2026/PCB_PCB_HydroStation-14-02-2026_ADC_moved-3_2026-02-16.json
doc/schemas/easyeda/16-02-2026/SCH_HydroStation-14-02-2026_2026-02-16.json
doc/schemas/easyeda/18-11-2025/PCB_PCB_ProMicro_evo2_v2_3_2025-11-15.json
doc/schemas/easyeda/18-11-2025/SCH_ESP32-v1_2025-11-17.json
doc/schemas/easyeda/18-11-2025/SCH_New-Project_2025-11-12.json
doc/schemas/easyeda/18-11-2025/SCH_Project2_2025-11-12.json
doc/schemas/easyeda/18-11-2025/SCH_ProMicro_evo2_2025-11-12.json
doc/schemas/easyeda/18-11-2025/SCH_ProMicro_evo2_v2_2025-11-15.json
doc/schemas/easyeda/18-11-2025/Sheet_3-copy_2025-11-12.schdoc
doc/schemas/easyeda/19-11-2025/PCB_PCB_ESP32-v1_3_2025-11-18.json
doc/schemas/easyeda/19-11-2025/SCH_ESP32-v1_2025-11-18.json
doc/schemas/easyeda/29-11-2025/Main-copy_2025-11-29.schdoc
doc/schemas/easyeda/29-11-2025/SCH_ESP32-v3_28-11-2025_2025-11-29.json
doc/schemas/easyeda/2025-10-27.json
doc/schemas/easyeda/2025-11-03.json
doc/schemas/easyeda/SCH_New-Project_2025-11-07.json
doc/schemas/easyeda/timer_23-01-2026/SCH_cd4060_timer_2026-01-23.json
