corlov/river-gauge/code/firmware/prod/full_device_esp32_v.08.02.2026/sensors.h

#include "globals.h"


String getBmeData();

String getAlwaysOnSensorsData();

String getPowerControlledSensorsData();

float getWaterTemperature();

float getActualWaterLevel();

void powerOff();

String getDateTime();

String getPowerData();

String getPowerControlledSensorsDataDump();
