corlov/river-gauge/code/firmware/prod/full_device_esp32_v.08.02.2026/water_lvl_init.cpp

#include "globals.h"
#include "water_lvl_init.h"
#include "water_lvl_settings.h"
#include "water_lvl_types.h"
#include "errors.h"



void indicateWakeUp() {
  digitalWrite(LED_PIN, HIGH);  
  delay(500);
  digitalWrite(LED_PIN, LOW);
}



void indicationSuccess() {
  int i = 0;
  while (i++ < 10) {
    digitalWrite(LED_PIN, HIGH);
    delay(100);
    
    digitalWrite(LED_PIN, LOW);
    delay(100);
  }  
}


void indicationSuccessWithoutSend() {
  int i = 0;
  while (i++ < 3) {
    digitalWrite(LED_PIN, HIGH);
    delay(800);
    
    digitalWrite(LED_PIN, LOW);
    delay(100);
  }  
}


void debugBlink(int arg_times, int arg_len1, int arg_len2) {
  int i = 0;
  while (i++ < arg_times) {
    digitalWrite(DEBUG_LED_PIN, HIGH);
    delay(arg_len1);
    digitalWrite(DEBUG_LED_PIN, LOW);
    delay(arg_len2);
  }
  delay(2000);
}




void indicationFail() {
  blinkErrorCode(ERR_CODE_SEND_ERROR);
  int i = 0;
  while (i++ < 3) {
    digitalWrite(LED_PIN, HIGH);
    delay(3000);
    digitalWrite(LED_PIN, LOW);
    delay(500);
  }
}




void initPins() {
  pinMode(LED_PIN, OUTPUT);

  pinMode(MODEM_POWER_PIN, OUTPUT);
  digitalWrite(MODEM_POWER_PIN, LOW);  

  pinMode(DONE_PIN, OUTPUT);
  digitalWrite(DONE_PIN, LOW);

  pinMode(ERRORE_LED_PIN, OUTPUT);
  digitalWrite(ERRORE_LED_PIN, LOW);

  pinMode(DEBUG_LED_PIN, OUTPUT);
  digitalWrite(DEBUG_LED_PIN, LOW);

  for (int pin : unusedPins) {
    pinMode(pin, INPUT_PULLDOWN);
  }
}



void initI2CSensors() {
  if (!rtc.begin()) {
    Serial.println("E1: RTC DS3231 is not found!");
    blinkErrorCode(ERR_CODE_RTC);
  }

  if (!bme.begin(0x76)) {
    Serial.println("E2: BME280 is not found!");
    blinkErrorCode(ERR_CODE_BME);
  }

  if (!ina219.begin()) {
    Serial.println("E3: INA219 is not found!");
    blinkErrorCode(ERR_CODE_INA219);
  }

  // раскоментировать 1 раз если надо синхронизовать датчик со времененм на ПК
  // rtc.adjust(DateTime(F(__DATE__), F(__TIME__)));
}


void initAds() {
  ads.begin();
  // Усиление GAIN_TWO подходит для диапазона +/- 2.048V.
  // Наш сигнал 0.4-2.0V идеально в него вписывается.
  ads.setGain(GAIN_TWO);
}



void init() {
  initPins();
  Serial.begin(115200);
  Wire.begin();

  indicateWakeUp();

  initAds();
  initI2CSensors();
}
