corlov/river-gauge/code/firmware/prod/full_device_esp32_v.08.02.2026/http.h

#include <Arduino.h>



String gatherChannelInfo();

bool sendHttpRequest(const char* server, uint16_t port, const String& message);

bool sendPayloadWithFallback(const String& payloadLog, const String& payload);
