corlov/river-gauge/code/firmware/prod/full_device_esp32_v.08.02.2026/water_lvl_init.h

void indicateWakeUp();

void indicationSuccess();

void indicationSuccessWithoutSend();

void indicationFail();

void initPins();

void initI2CSensors();

void init();

void debugBlink(int arg_times, int arg_len1, int arg_len2);
