corlov/river-gauge/code/firmware/prod/full_device_esp32_v.08.02.2026/process_response.h

#include <ArduinoJson.h> 


bool updateRtcFromServerTime(const char* timeString);

bool processServerResponse(const String& responseBody);

void settingsCallback(char* topic, byte* payload, unsigned int length);
