corlov/river-gauge/code/firmware/sandbox/full_device_esp32_v3/full_device_esp32_v3.ino

#include "water_lvl_types.h"
#include "water_lvl_settings.h"
#include "water_lvl_init.h"
#include "globals.h"
#include "storage.h"
#include "sensors.h"
#include "send_data.h"



int wl_measure_samples[SAMPLES_SIZE];

RTC_DS3231 rtc;

Adafruit_BME280 bme;

HardwareSerial SerialGSM(1);

TinyGsm modem(SerialGSM);

TinyGsmClient client(modem);

OneWire oneWire(WATER_TEMPERATURE_SENSOR_PIN);

DallasTemperature sensors(&oneWire);

Preferences preferences;

Adafruit_ADS1115 ads;

Adafruit_INA219 ina219;

//#define DEBUG_MODE 1



void setup() {
  init();
  modemOn();

  #ifdef DEBUG_MODE
    return;
  #endif

  String defaultSensorsData = getAlwaysOnSensorsData();
  String fullMessage = defaultSensorsData + getPowerControlledSensorsData() + getVoltData();
  Serial.println(fullMessage);

  if (attemptToSendLogs(fullMessage)) {
      Serial.println('[ok]');
      //setSuccess(true);
      indicationSuccess(2);
    } else {
      Serial.println('[fail]');
      //setSuccess(false);
      indicationFail();
      
    }

  modemOff();
  powerOff();


  // if (0) {
  // //PrevState prevState = getPrevState();

  // String defaultSensorsData = getAlwaysOnSensorsData();

  // //if ((prevState.bootCount % DAILY_INTERVAL == 0) || (!prevState.success)) {
  //   indicationInProgress();
    

  //   // подаем питание на модем и цепи датчиков
  //   digitalWrite(MODEM_POWER_PIN, HIGH);
  //   delay(5000);

  //   String fullMessage = defaultSensorsData; //+ getPowerControlledSensorsData();

  //   //printProMicroData();

  //   //addCsvLine(fullMessage);

  //   if (attemptToSendLogs(fullMessage)) {
  //     Serial.println('[ok]');
  //     //setSuccess(true);
  //     //indicationSuccess(2);
  //   } else {
  //     Serial.println('[fail]');
  //     //setSuccess(false);
  //     //indicationFail();
  //   }

  //   Serial.println('before reset modem');

  //   digitalWrite(MODEM_POWER_PIN, LOW);

  //   digitalWrite(RESET_MODEM_PIN, HIGH);
  //   delay(100);
  //   digitalWrite(RESET_MODEM_PIN, LOW);
  //   delay(5000);
  // // }
  // // else {
  // //   addCsvLine(defaultSensorsData);
  // //   indicationSuccess(1);
  // // }

  // powerOff();
  // }

  Serial.println('end setup');
}



void loop() {
  #ifdef DEBUG_MODE
    //indicateWakeUp();

    String defaultSensorsData = getAlwaysOnSensorsData();
    String fullMessage = defaultSensorsData + getPowerControlledSensorsData() + getVoltData();
    Serial.println(fullMessage);
    delay(5000);

    // if (attemptToSendLogs(fullMessage)) {
    //     Serial.println('[ok]');
    //     //setSuccess(true);
    //     indicationSuccess(2);
    //   } else {
    //     Serial.println('[fail]');
    //     //setSuccess(false);
    //     indicationFail();
    //   }

    //delay(10000);
  #else
    return;
  #endif






  // String defaultSensorsData = getAlwaysOnSensorsData();
  // String fullMessage = defaultSensorsData; //+ getPowerControlledSensorsData()
  // Serial.println(fullMessage);
  // delay(2000);






  // Serial.println('loop');

  // indicateWakeUp();

  // String defaultSensorsData = getAlwaysOnSensorsData();

  
  // digitalWrite(MODEM_POWER_PIN, HIGH);
  // delay(5000);

  // String fullMessage = defaultSensorsData;

  // if (attemptToSendLogs(fullMessage)) {
  //   setSuccess(true);
  //   indicationSuccess(2);
  // } else {
  //   setSuccess(false);
  //   indicationFail();
  // }
  
  // //digitalWrite(MODEM_POWER_PIN, LOW);
  // digitalWrite(RESET_MODEM_PIN, HIGH);
  // delay(100);
  // digitalWrite(RESET_MODEM_PIN, LOW);
  // delay(5000);
}
