corlov/river-gauge/(commit log)

2025-10-27 Добавил схему отключения питания и описания
    [2025-10-27.json]
2025-10-28 feat: добавил новую схему, использую энергоэфективный конвертер напряжения чтобы питать таймер, добавил даташиты по используемым компонентам на схеме
    [2025-10-27.json]
2025-10-29 feat: вариант схемы где повсеместно используется готовая сборка ключа на транзисторах
    [Смета.xlsx]
2025-10-29 feat: вариант схемы где повсеместно используется готовая сборка ключа на транзисторах v2
2025-11-07 feat: прошивка для ПроМикро и добился управления питанием СИМ800 через П-канальный мосфет. Работает отправка данных с датчиков через модуль связи и аппаратно-программное управление питанием пока по т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
    [2025-11-03.json]
2025-11-07 feat: добавил скетч с делителем, собрал джелитель по прложеной схеме на Н-канальном мосфете и работает
    [SCH_New-Project_2025-11-07.json]
2025-11-18 feat: новая полная прошивка версии 1 для ЭСП32 и схемы
    [PCB_PCB_ProMicro_evo2_v2_3_2025-11-15.json, PCB_PCB_Project2_9_2025-11-09.json, SCH_ESP32-v1_2025-11-17.json, SCH_New-Project_2025-11-12.json, SCH_ProMicro_evo2_2025-11-12.json, SCH_ProMicro_evo2_v2_2025-11-15.json, SCH_Project2_2025-11-09.json, SCH_Project2_2025-11-12.json]
2025-11-18 feat: дописывание прошивки, корректировки схемы с указанием номиналов компонентов
    [PCB_PCB_ESP32-v1_3_2025-11-18.json, SCH_ESP32-v1_2025-11-18.json]
2025-11-25 feat: собираю устройство, прошивка терпит корректирвки
    [received_data.csv]
2025-11-28 feat: в каталоге prod лежит версия которая с датчиков собирает данные и отправляет на сервер без датчика уровня и ввольтметра
    [Смета.xlsx]
2025-11-30 feat: рабочая версия
    [Main-copy_2025-11-29.schdoc, SCH_ESP32-v3_28-11-2025_2025-11-29.json, Смета.xlsx]
2025-11-30 feat: работающая прошивка с датчиком напряжения ina219
2025-12-02 feat: настройки обратно на устройство передаются
    [received_data.csv, received_data_1.csv, received_data_2.csv, received_data_3.csv]
2025-12-03 feat: схемы переделанные актальные - отдаю первую партию на Завод
    [Electrical_2025-12-03.schdoc, PCB_PCB_ESP32-v3_01-12-2025_2.1_2025-12-03.json, SCH_ESP32-v3_01-12-2025_2025-12-03.json]
2025-12-05 feat: прототипы приема информации на сервере связка MQTT + InfluxDB"
2025-12-07 feat: добавил в прошивку отправку в protobuf в MQTT брокер и серверный скрипт приема данных и раскладки по influxdb
2025-12-07 feat: серверная часть приема
2025-12-08 feat: прием из отдельного тописка настроек, добавил дебаговый лед
    [Смета.xlsx]
2025-12-09 feat: структуризация кода, прием ответов из топика Конфигаи применение настроек
2025-12-09 feat: хороший вариант прошивки - законченный с блинком ошибок по коду, отправкой нескольких сообщений по МКТТ прием настроек из брокерв
    [received_data.csv, received_data_1.csv, received_data_2.csv, received_data_3.csv]
2025-12-23 feat: начал проработку идеи замены 5110 на attiny85, также выяснилось что mini360 также надо менячть на тсабилизатор т.к. он очень много потребляет тока, нукжны наноамперы. 5110 в итоге вышел из стро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
2025-12-24 feat: чуть модифицированая прошивка в плане того что поубирал немного задержек чтобы все чуть быстрее происходило
2026-01-23 feat: схема с таймером на базе каскада из ht7550 ht7333 и cd4060 + получением сигнала DONE
    [SCH_cd4060_timer_2026-01-23.json, Замеры_таймера.ods]
2026-02-09 feat; добавил фото с тем как выгляит устройство, статистику с испытаниями схемы таймера. пока победило решение на базе каскада ht7550 + ht7333a
    [Замеры_таймера.ods]
2026-02-16 feat: новый вариант прошивки (ее надо дошлифовать), вариант схемы с учетом исправлений от версии 1
    [Main_2026-02-16.schdoc, PCB_PCB_HydroStation-14-02-2026_3_2026-02-16.json, PCB_PCB_HydroStation-14-02-2026_ADC_moved-3_2026-02-16.json, SCH_HydroStation-14-02-2026_2026-02-16.json, Замеры_таймера.ods]
2026-02-25 feat: добавил watchdog в прошивку, прикрепил статистику по потреблению АКБ
    [received_data.csv, stata.csv, stata2.csv, Замеры_таймера.ods]
